ryanshappa/Dynamometer-Project/imgs/wiring.png

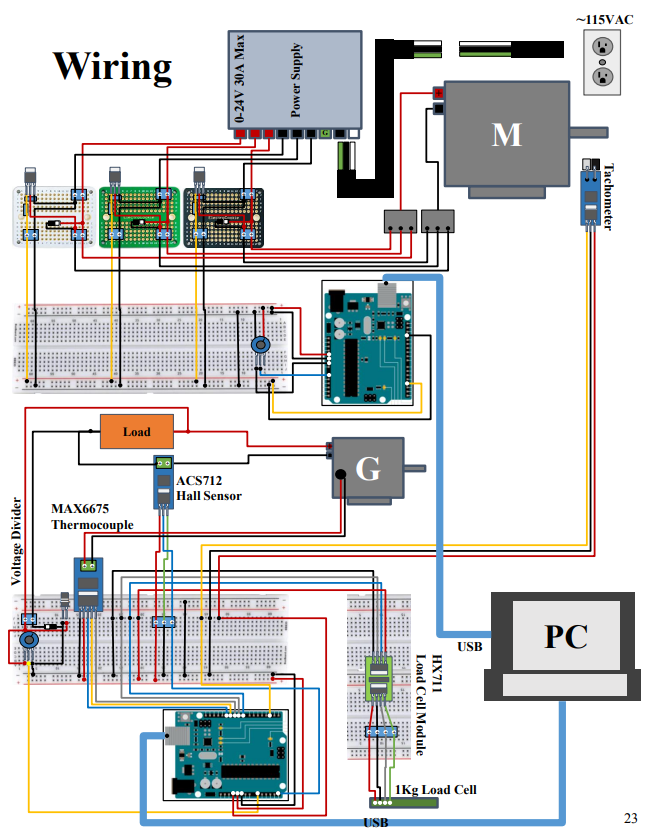
imgs/wiring.png
