ryanshappa/Dynamometer-Project/imgs/dyno_edited.jpg

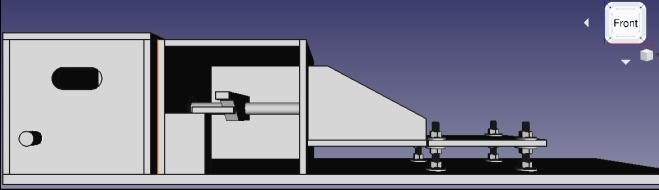
imgs/dyno_edited.jpg
