ryanshappa/Dynamometer-Project/README.md

# Dynamometer-Project
Created a Dynamometer from scratch to take automated metrology tests on any type of generator

All wiring was done from breadboards and code was implemented through multuple Arduinos with code written through Arduino IDE

# IMGS
Check imgs folder for screenshots of conceptual design, wiring diagram, and 3D model created of dynamometer

# Report
Be sure to check out the report that was created explaining the project in more detail and also showing the results of the project!
