ryanshappa/Dynamometer-Project/EGR_450_Final_Report.pdf

Tom DeLine | Capstone

# Engineering 450

# North Central College

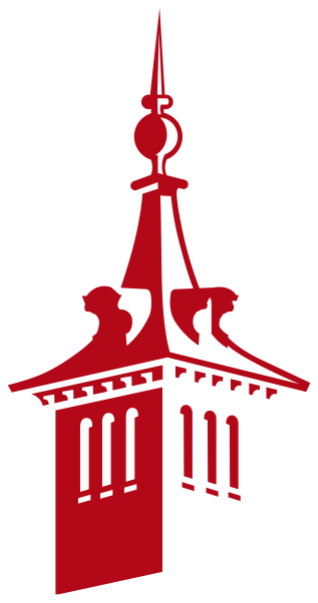
[picture p3: figure]

## Engineering Student: Tom DeLine

## Engineering Professor: Dr Harwath

## Capstone Project

## Subject: Dynamometer

Start: | 8/31/2021
End: | 12/12/2021

## Ryan Shappa & Tom Deline

## Executive Summary

## Problem Statement

## Specifications

## - Subcomponent Specifications

## Concept

## Design

## Wiring

## Design Analysis

## Bill of Material

## Budget

## Schedule

## Results/Data

## Generator Performance

## Conclusion

## References

# Table of Contents

3
4
5
6-13
14
15-22
23
24-30
31
32
33
34-39
40-46
47
48

The purpose of this project was to build a machine capable of measuring the performance of

electric motors and generators. To evaluate performance, the Dynamometer motor is directly

coupled to the shaft of the motor/generator being measured. Once coupled, the machine determines

how much torque is required to spin the shaft at different RPMs with an electric load attached to the

electric terminals of the motor/generator being measured.

To determine the torque required,

the motor of the Dynamometer is mounted in the machine

such that the body of the motor is capable of freely rotating

about the central axis of the shaft. By measuring the rotational

force applied to the central axis shaft while the machine is on, a relationship can be developed

between torque, RPM, and load.

To control the Dynamometer, a serial console session can be established with the machine by USB

cable. After establishing the connection,

the user is prompted with a decision tree

to select how the machine operates.

In Dynamometer mode, the user can

select from a list of speed profiles;

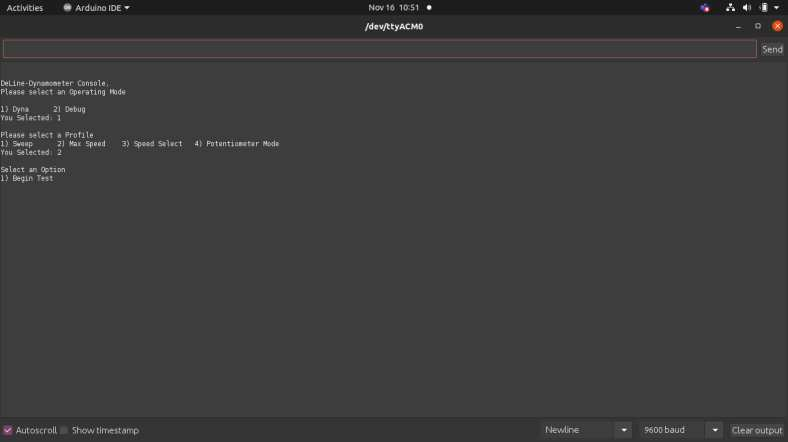
[picture p4: figure]

1)Sweep | 2)Max Speed | 3)Speed Select | 4)Potentiometer Mode

The data is recorded in a csv file through a second serial connection monitored and recorded by

putty console logger. The output can be exported to a graphing program such as Microsoft Excel.

# Executive Summary

Load Cell

Fig 1: Machine motor body
rotating around central shaft

Fig 2: Serial Console Session Established through Arduino IDE

# Problem Statement

The customer requires the ability to evaluate

the power output of a motor/generator to determine

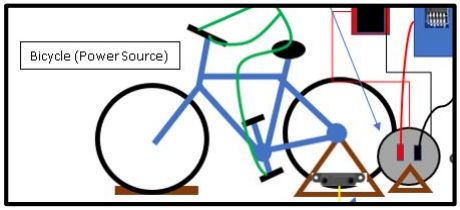
[picture p5: figure]

the feasibility of using different motor sizes/types

for a bicycle powered electric generator.

The generator attached to the bicycle in Fig 3 is the

component which the customer requires the ability

to be evaluated.

A dynamometer is a device capable of evaluating motor performance under load. The

dynamometer needs to be capable of measuring RPM, determine the output Voltage/Current from

the generator, determine the torque required to spin the motor, and measure the motor temperature vs

power output. Normally, this type of machine (dynamometer) would measure the torque produced

by the motor being evaluated. In this specific application however, the machine measures the torque

required to rotate the generator shaft for loaded/unloaded conditions.

Fig 3: Customer’s bicycle powered
electric generator

# Specifications

Dynamometer: This machine is capable of evaluating the performance of electric motors/generators.

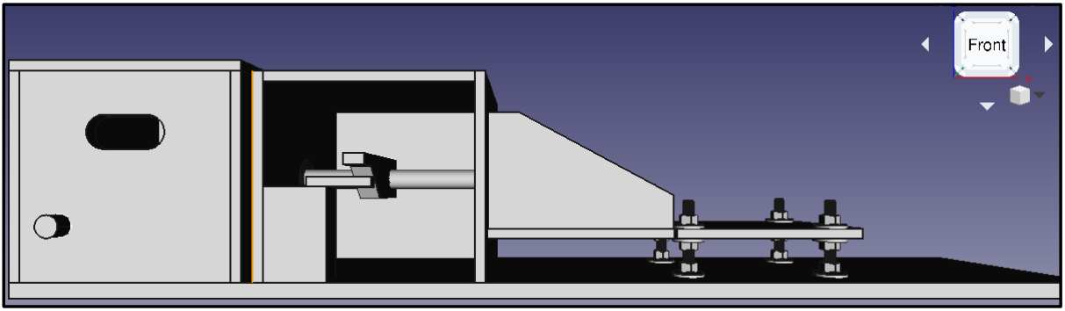
[picture p6: figure]

COST | $276
MACHINE MOTOR OUTPUT | 500W
MAX SPEED | 2500 RPM
INPUT VOLTAGE | 120/240V AC
ELECTRICAL PLUG | NEMA 5-15P
PEAK CURRENT | 20A
NO-LOAD CURRENT | 2.2A
MAX TORQUE | 2 Nm
MAX ATTACHED MOTOR TORQUE | 2 Nm
MAX ATTACHED MOTOR WEIGHT | 20lbs
MACHINE WEIGHT | 50lbs
MAX ATTACHED MOTOR POWER | 480W
MACHINE FLOOR SPACE | 240mm Wide x 720mm Long x 250mm Tall
MACHINE INTERFACE | USB-B x 2
SPEED PROFILES | 4

Fig 4: Dynamometer Machine Assembly

# Specifications Continued

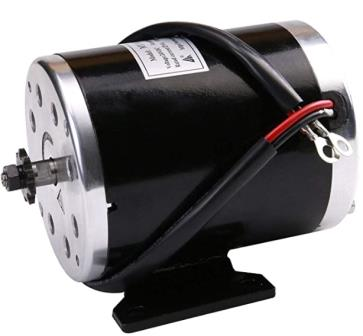
[picture p7: figure]
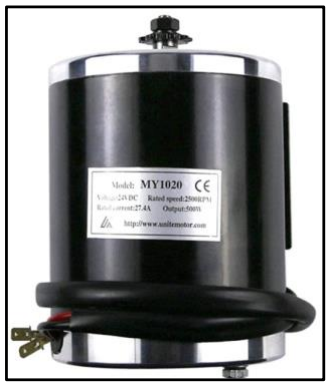
[picture p8: figure]
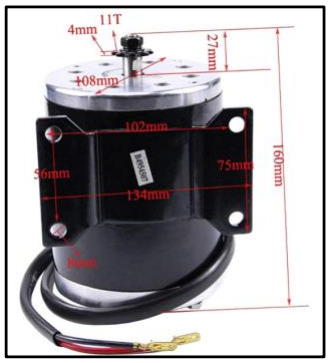
[picture p9: figure]
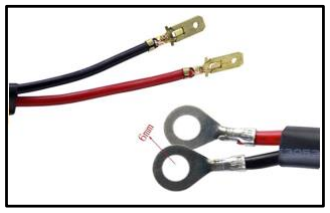
[picture p10: figure]

https://www.amazon.com/WPHMOTO-Brushed-Electric-Scooter-Bicycle/dp/B078RKRV5P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

## Product Link:

COST | $78.89
OUTPUT | 500W
RATED SPEED | 2500 RPM
RATED VOLTAGE | 24V DC
RATED CURRENT | 27.4A
NO-LOAD CURRENT | 2.2A
RATED TORQUE | 1.5Nm
PEAK EFFICIENCY AT 24V | 78%
REVERSIBLE | (with polarity swap)
MOTOR WEIGHT | 9lbs (4kg)
MAXIMUM LOAD | 200lbs (90kg)

## Dynamometer Motor:

## Dynamometer Power Supply:

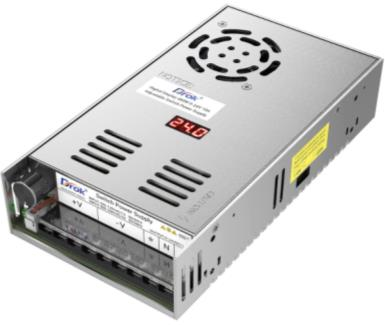
[picture p11: figure]
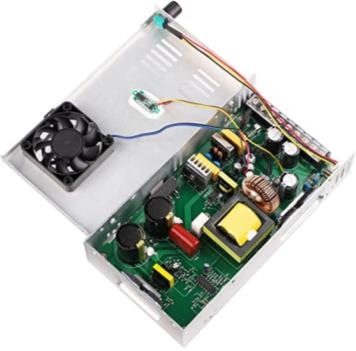
[picture p12: figure]
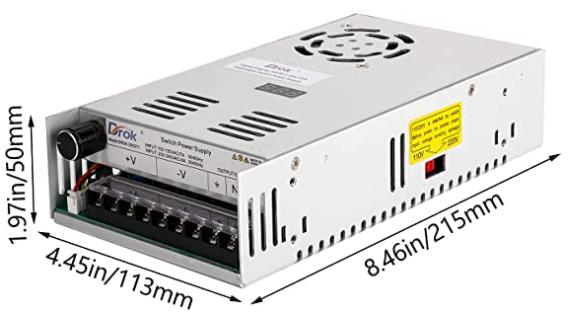
[picture p13: figure]
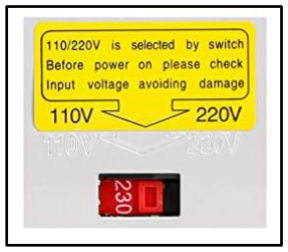
[picture p14: figure]

Amazon.com: Adjustable Voltage DC Power Supply, DROK AC 110V-220V to DC Output 0-24V, LED Digital Display 12V 24V 20A 480W Switching Power Supply Regulated Converter Step Down Transformer Built in Cooling Fan : Electronics

## Product Link:

COST | $35.99
OUTPUT POWER | 480W
INPUT VOLTAGE | 110V-220V
RATED OUTPUT VOLTAGE | 0-24V DC
MAX OUTPUT CURRENT | 20A
WEIGHT | 1.94lbs (0.88kg)

# Specifications Continued

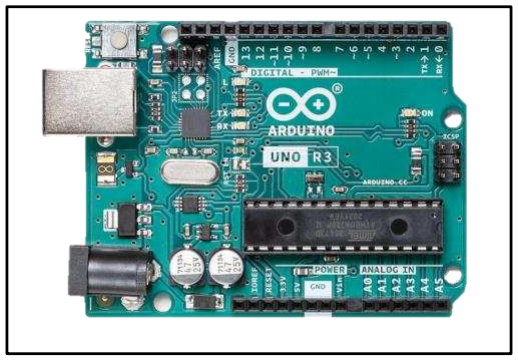
[picture p15: figure]

COST | $23.00
MICROCONTROLLER | ATmega328P
OPERATING VOLTAGE | 5V
INPUT VOLTAGE (RECOMMENDED) | 7-12V
INPUT VOLTAGE (LIMIT) | 6-20V
DIGITAL I/O PINS | 14 (of which 6 provide PWM output)
PWM DIGITAL I/O PINS | 6
ANALOG INPUT PINS | 6
DC CURRENT PER I/O PIN | 20 mA
DC CURRENT FOR 3.3V PIN | 50 mA
FLASH MEMORY | 32 KB (ATmega328P) of which 0.5 KB used by bootloader
SRAM | 2 KB (ATmega328P)
EEPROM | 1 KB (ATmega328P)
CLOCK SPEED | 16 MHz
LED_BUILTIN | 13
LENGTH | 68.6 mm
WIDTH | 53.4 mm
WEIGHT | 25 g

## Product Link:

https://store-usa.arduino.cc/products/arduino-uno-rev3

## Dynamometer Controller:

# Specifications Continued

## Dynamometer Controller Continued:

# Specifications Continued

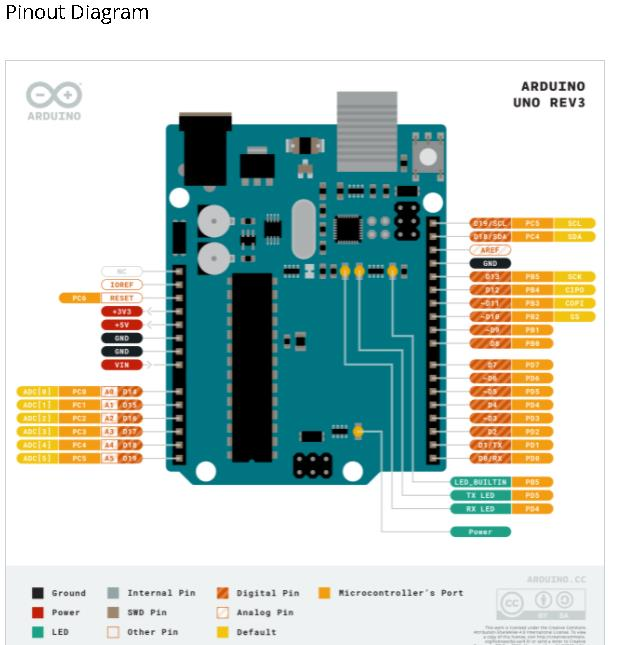
[picture p16: figure]

Fig 4: Dynamometer Controller Pin Diagram

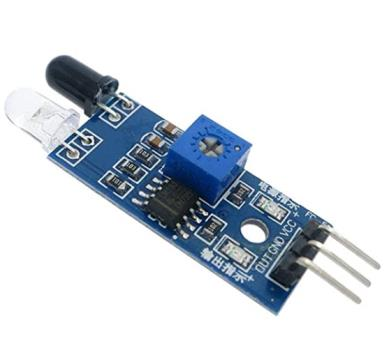
[picture p17: figure]

## Product Link:

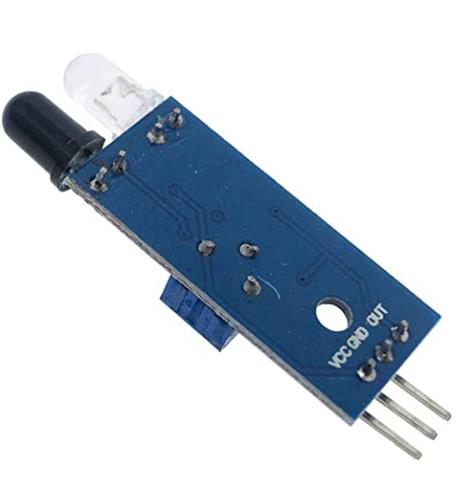
[picture p18: figure]

Amazon.com: HiLetgo 10pcs IR Infrared Obstacle Avoidance Sensor Module for Arduino Smart Car Robot 3-Wire Reflective Photoelectric for Arduino Smart Car Robot : Electronics

COST | $0.83 / Module
BRAND NAME | HiLetgo
COLOR | Blue
VOLTAGE | 3.3V / 5V
MINIMUM DISTANCE | 2cm
MAXIMUM DISTANCE | 30cm
DIGITAL I/O PINS | 3
PIN DEFINITION | OUT, GND, VCC
INTERFACE | I2C
SIZE | 15mm x 34.5mm
VALUE ADJUST | Potentiometer

# Specifications Continued

## Photoelectric Tachometer:

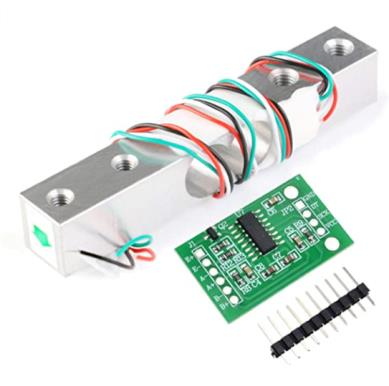
[picture p19: figure]
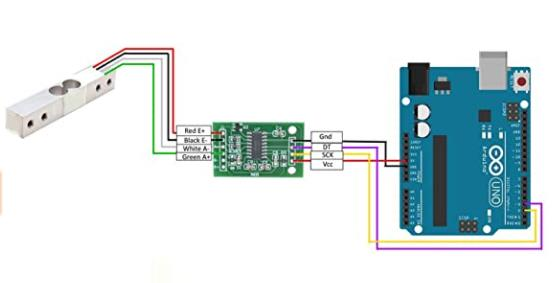
[picture p20: figure]

## Product Link:

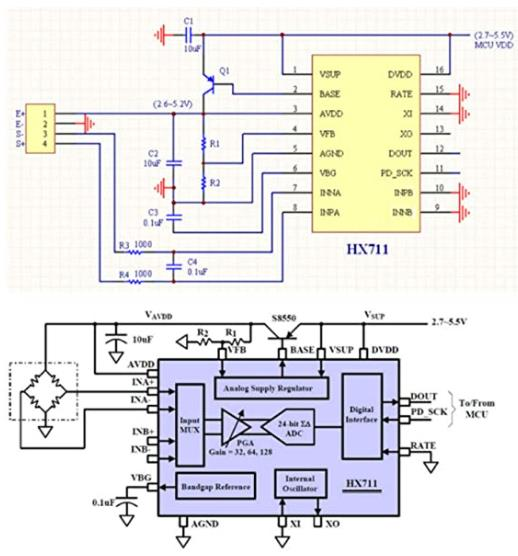
[picture p21: figure]
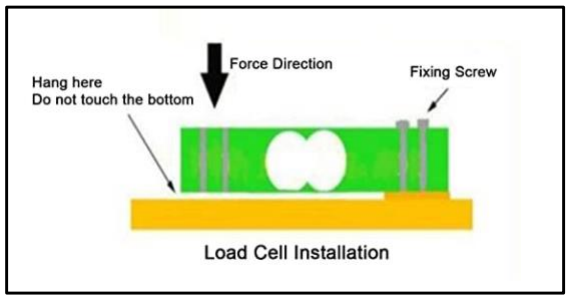
[picture p22: figure]

Amazon.com: ALAMSCN Digital Load Cell Weight Sensor + HX711 Weighing Sensor ADC Module for Arduino DIY Portable Electronic Kitchen Scale Kit (1KG+HX711) : Industrial & Scientific

COST | $7.99
BRAND NAME | ALAMSCN
OUTPUT DATA RATE | 10Hz or 80Hz
VOLTAGE | 5V-10V
MAX LOAD FORCE | 1Kg
ACCURACY | 0.1g
DIGITAL I/O PINS | 4
PIN DEFINITION | GND, DT, SCK, VCC
INTERFACE | I2C

# Specifications Continued

## Digital Load Cell with Module

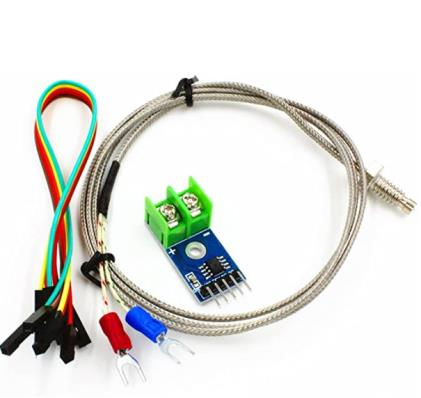
[picture p23: figure]

## Product Link:

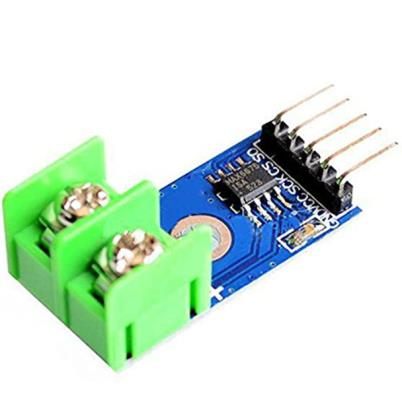
[picture p24: figure]

Amazon.com: ALAMSCN Digital Load Cell Weight Sensor + HX711 Weighing Sensor ADC Module for Arduino DIY Portable Electronic Kitchen Scale Kit (1KG+HX711) : Industrial & Scientific

COST | $7.99
BRAND NAME | ALAMSCN
OUTPUT DATA RATE | 10Hz or 80Hz
VOLTAGE | 3.3V / 5 V
MIN TEMP | 0°C
MAX TEMP | 1024°C
DIGITAL I/O PINS | 5
PIN DEFINITION | GND, VCC, SCK, CS, SO
INTERFACE | SPI
MODULE SIZE | 15mm x 28mm

# Specifications Continued

## Thermocouple with Module

## Product Link:

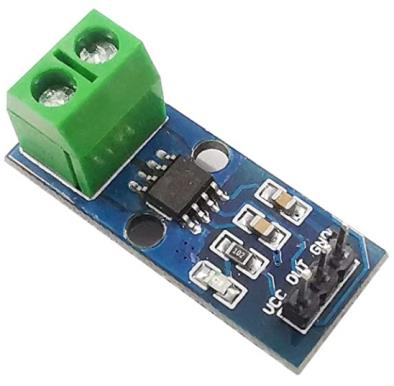
[picture p25: figure]

Amazon.com: ZkeeShop 5pcs 5A Current Sensor Module ACS712 Module Compatible for Arduino : Electronics

COST | $12.99
BRAND NAME | ZkeeShop
VOLTAGE | 5 V
MIN CURRENT | 0
MAX CURRENT | 30A
DIGITAL I/O PINS | 3
PIN DEFINITION | VCC, Out, GND
INTERFACE | Analog Voltage
MODULE SIZE | 15mm x 28mm

# Specifications Continued

## Current Sensor Module

# Concept

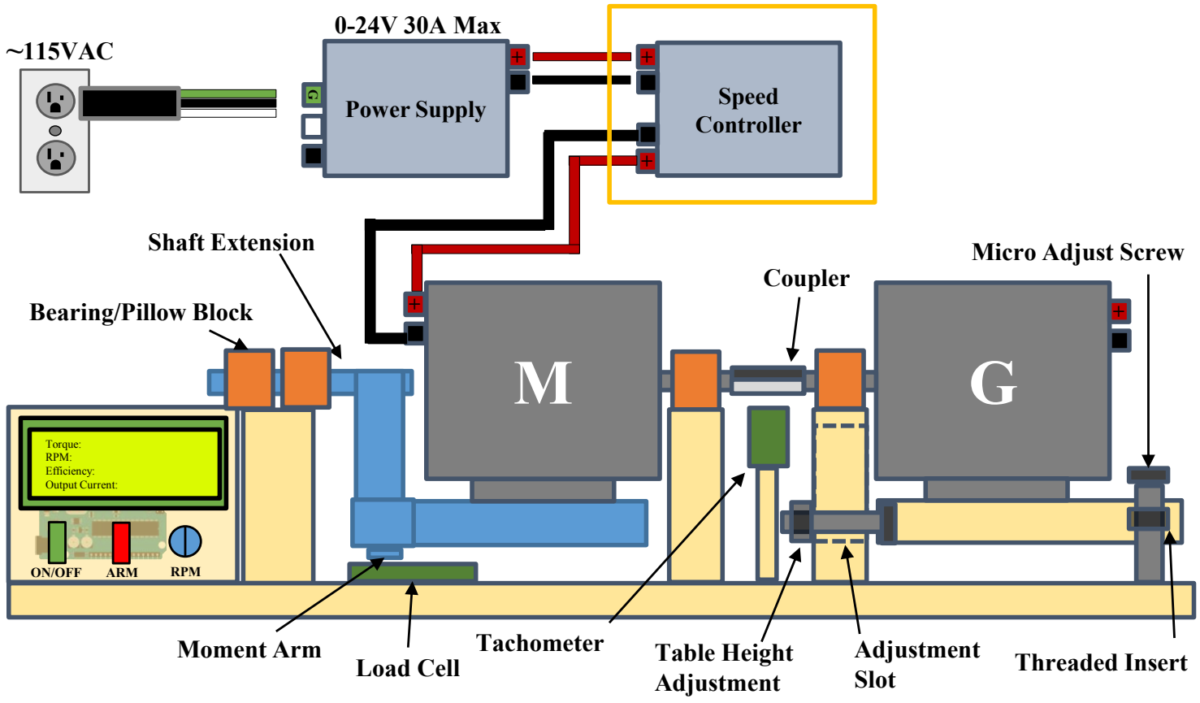
[picture p26: figure]
Bearing/Pillow Block; Shaft Extension; Coupler; Threaded Insert; Micro Adjust Screw; Table Height Adjustment; Adjustment Slot; Torque: RPM: Efficiency: Output Current:; Tachometer; Load Cell; ON/OFF; RPM; Moment Arm; ARM; ~115VAC; Power Supply; 0-24V 30A Max; Speed Controller
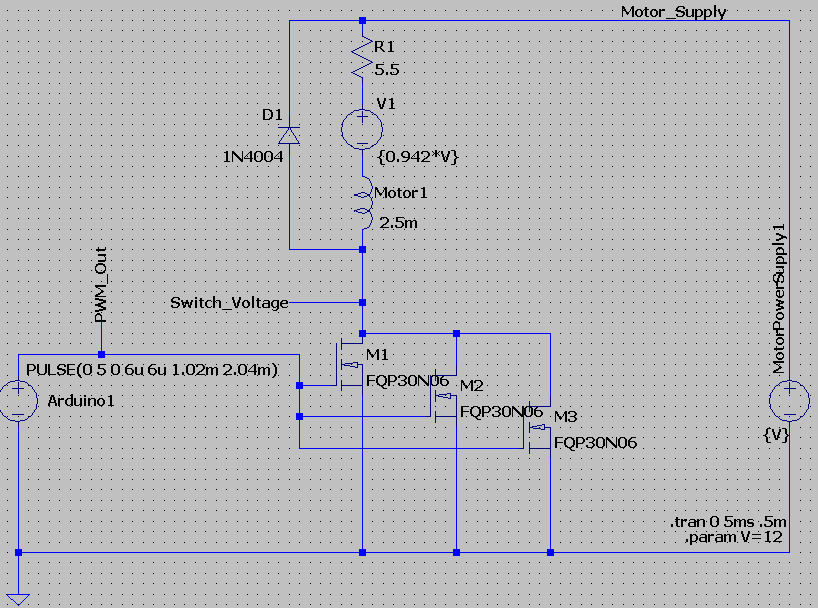
[picture p27: figure]

Fig 6: Motor Speed Controller Circuit

Fig 5: Dynamometer Concept Diagram

# Design

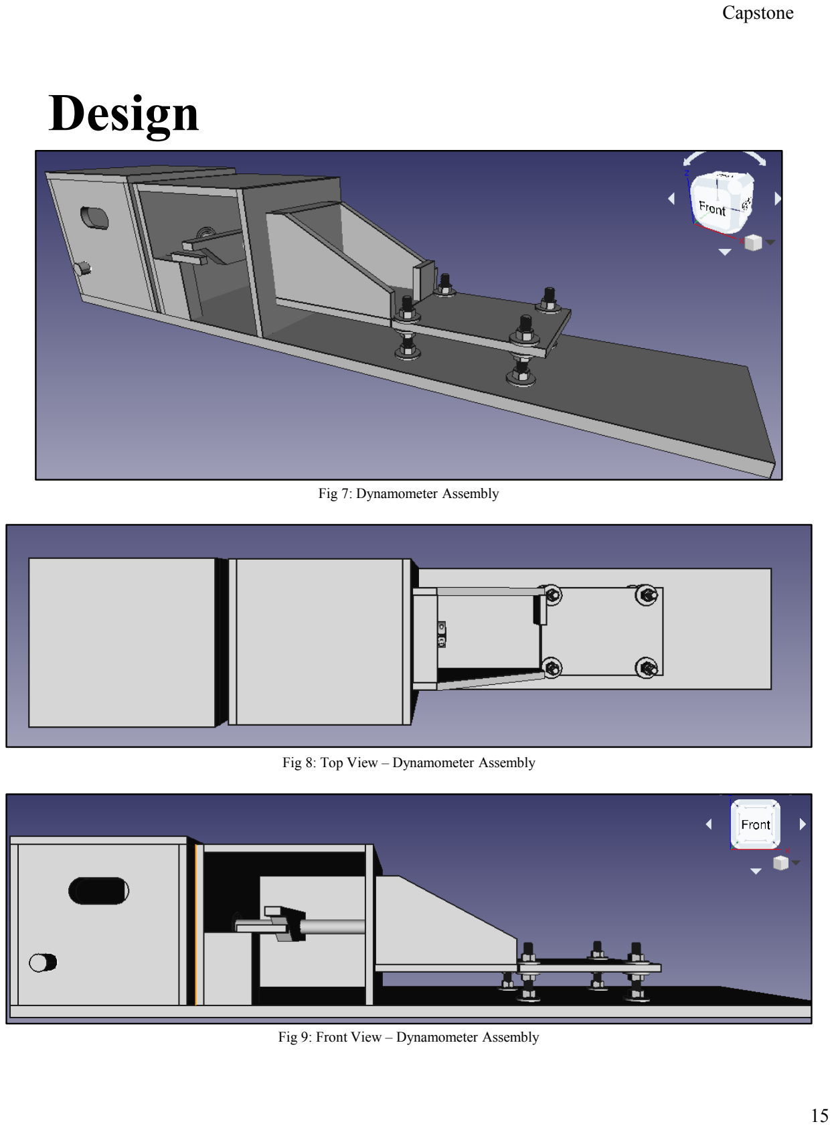
[picture p28: page 15]

Fig 7: Dynamometer Assembly

Fig 8: Top View – Dynamometer Assembly

Fig 9: Front View – Dynamometer Assembly

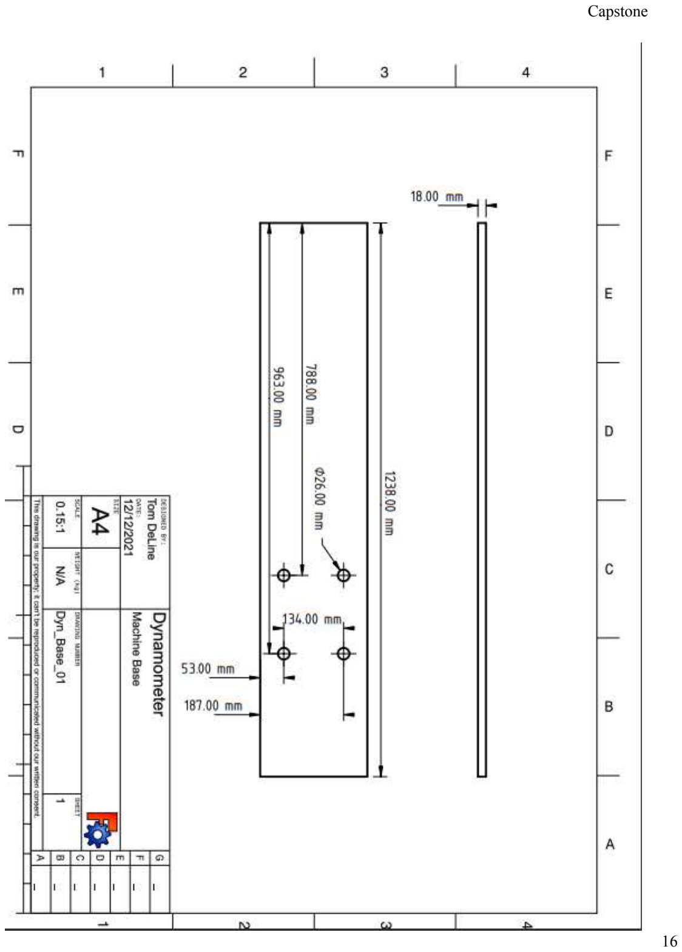
[picture p29: page 16]
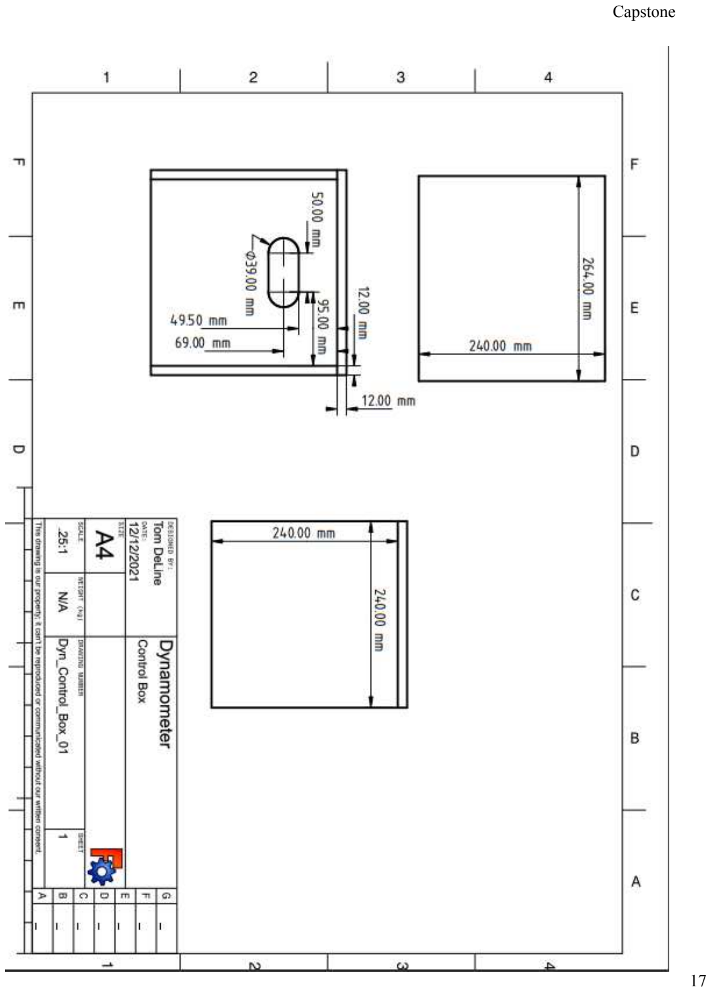
[picture p30: page 17]
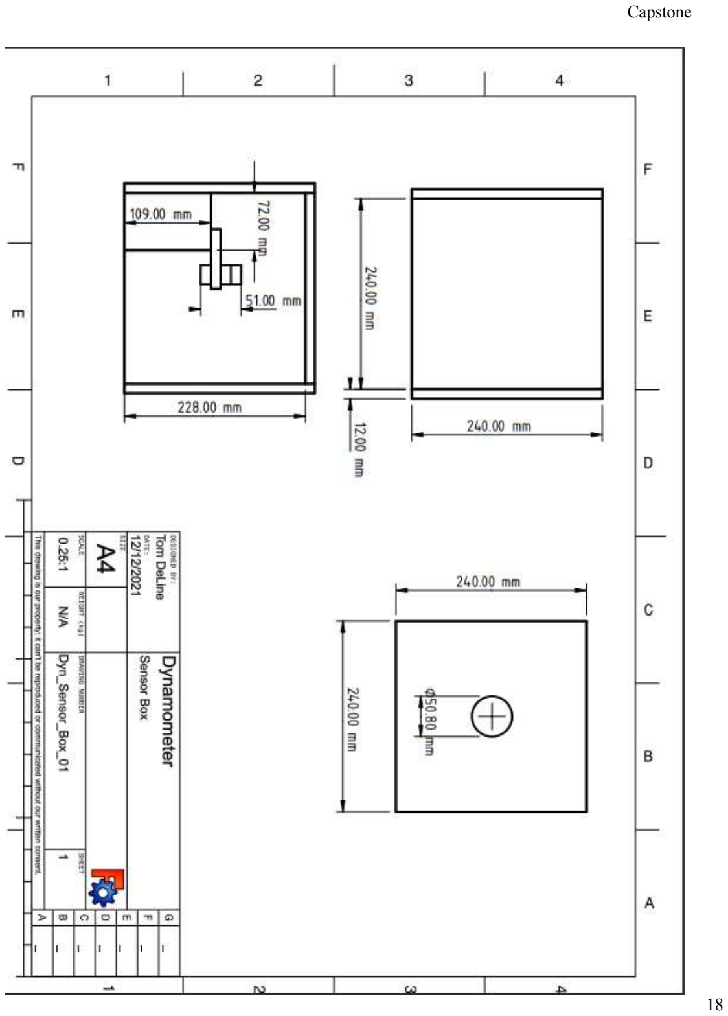
[picture p31: page 18]
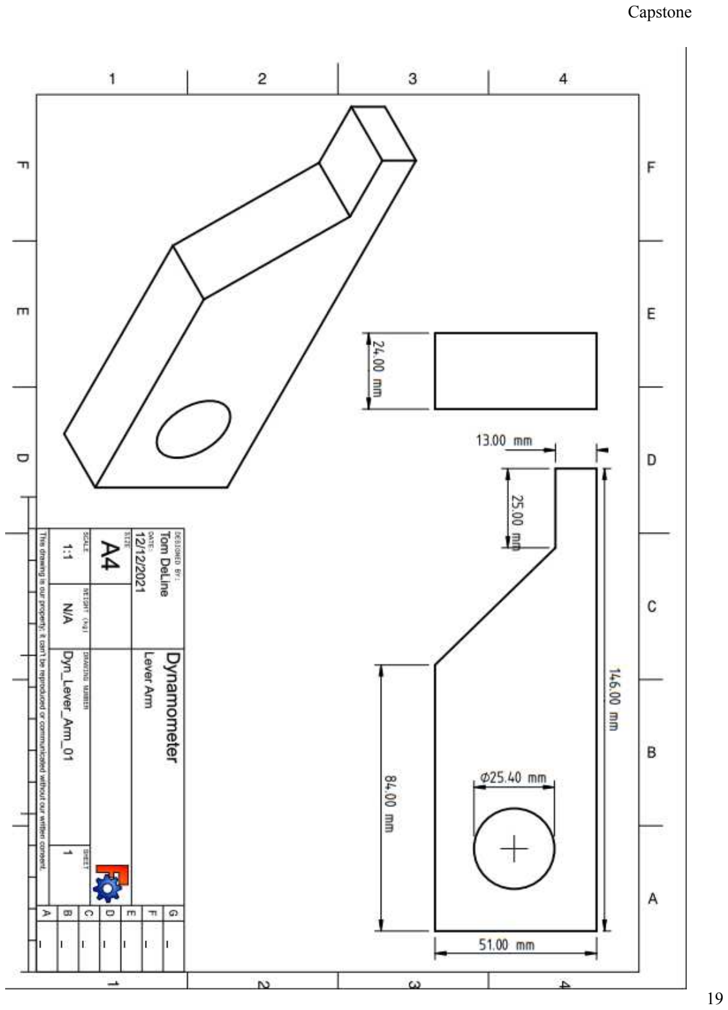
[picture p32: page 19]
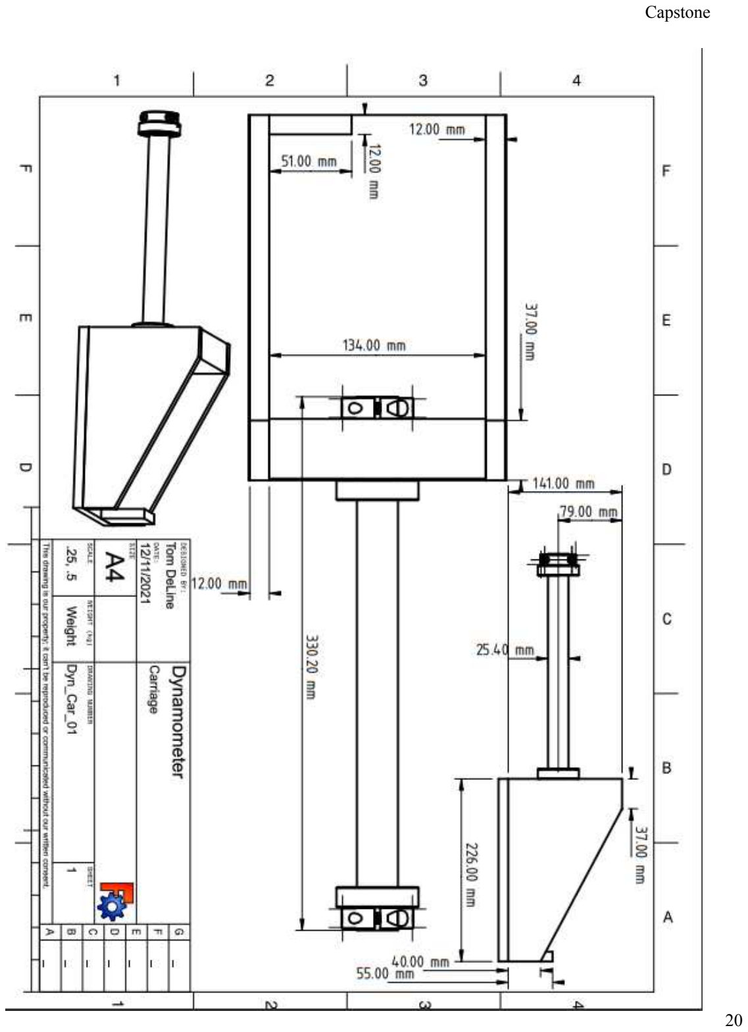
[picture p33: page 20]
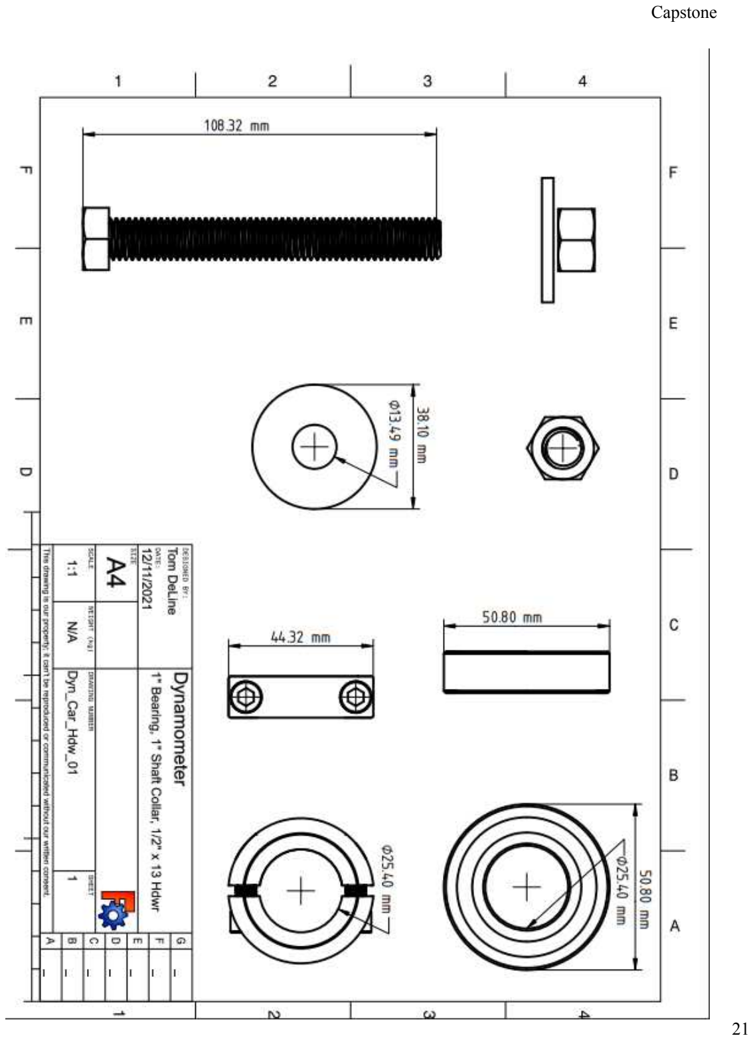
[picture p34: page 21]
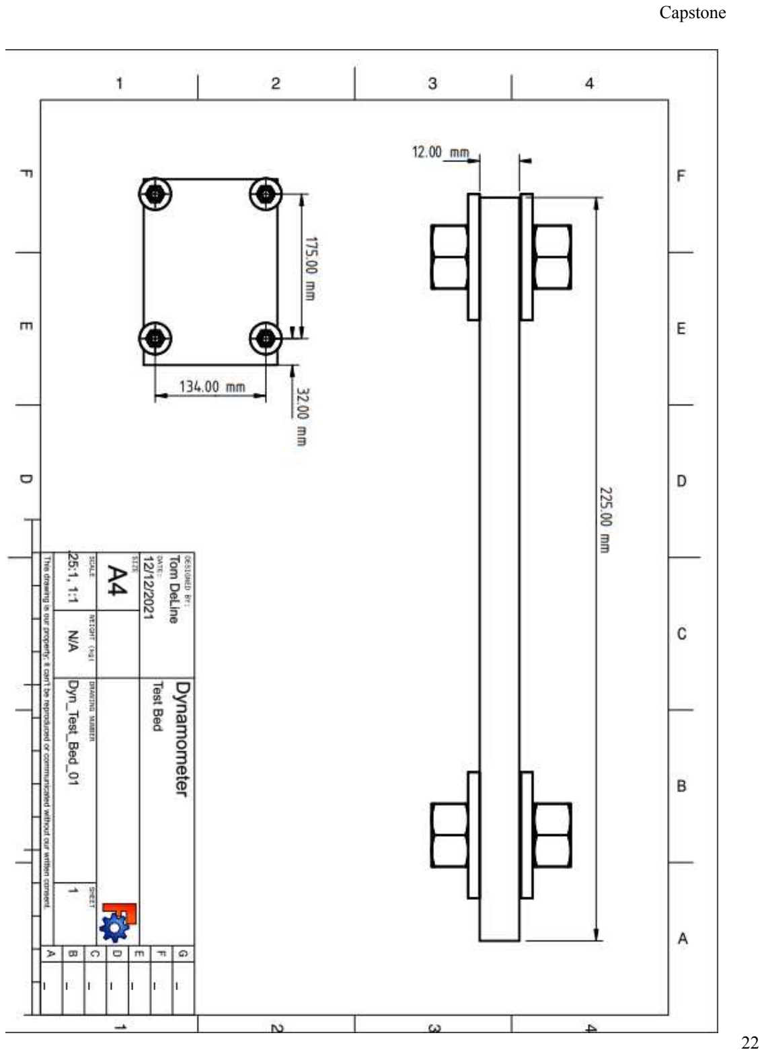
[picture p35: page 22]

M

# Wiring

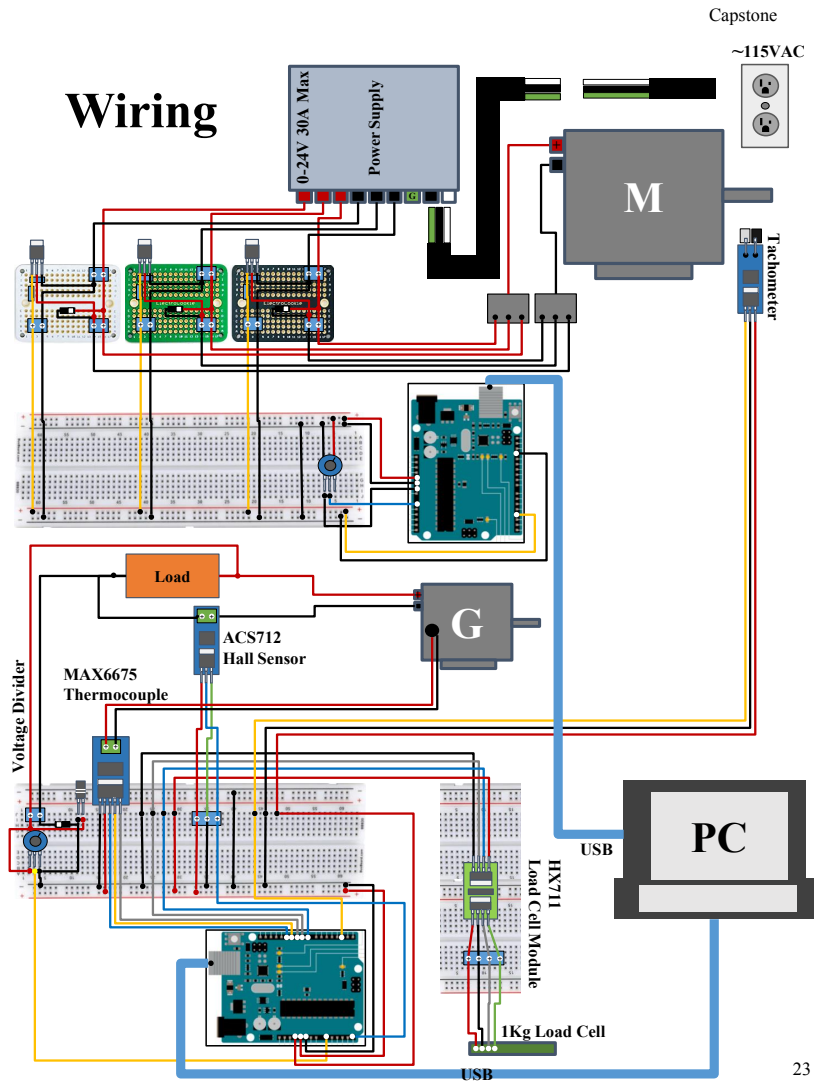
[picture p36: page 23]
~115VAC; G G Power Supply; 0-24V 30A Max; Load; 1Kg Load Cell; USB; Tachometer; ACS712 Hall Sensor; MAX6675 Thermocouple; Voltage Divider

Load Cell Module

# Design Analysis

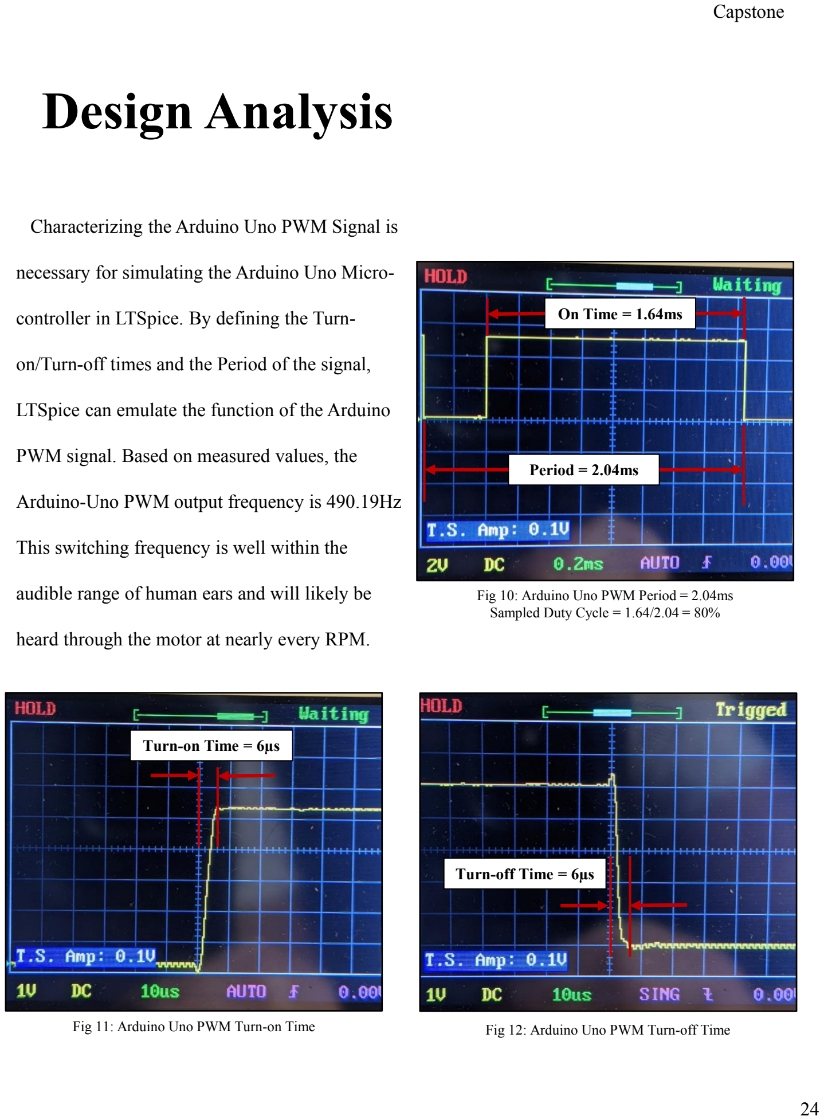
[picture p37: page 24]

Fig 10: Arduino Uno PWM Period = 2.04ms Sampled Duty Cycle = 1.64/2.04 = 80%

Period = 2.04ms

On Time = 1.64ms

Turn-on Time = 6µs

Fig 11: Arduino Uno PWM Turn-on Time

Turn-off Time = 6µs

Fig 12: Arduino Uno PWM Turn-off Time

Characterizing the Arduino Uno PWM Signal is

necessary for simulating the Arduino Uno Micro-

controller in LTSpice. By defining the Turn-

on/Turn-off times and the Period of the signal,

LTSpice can emulate the function of the Arduino

PWM signal. Based on measured values, the

Arduino-Uno PWM output frequency is 490.19Hz

This switching frequency is well within the

audible range of human ears and will likely be

heard through the motor at nearly every RPM.

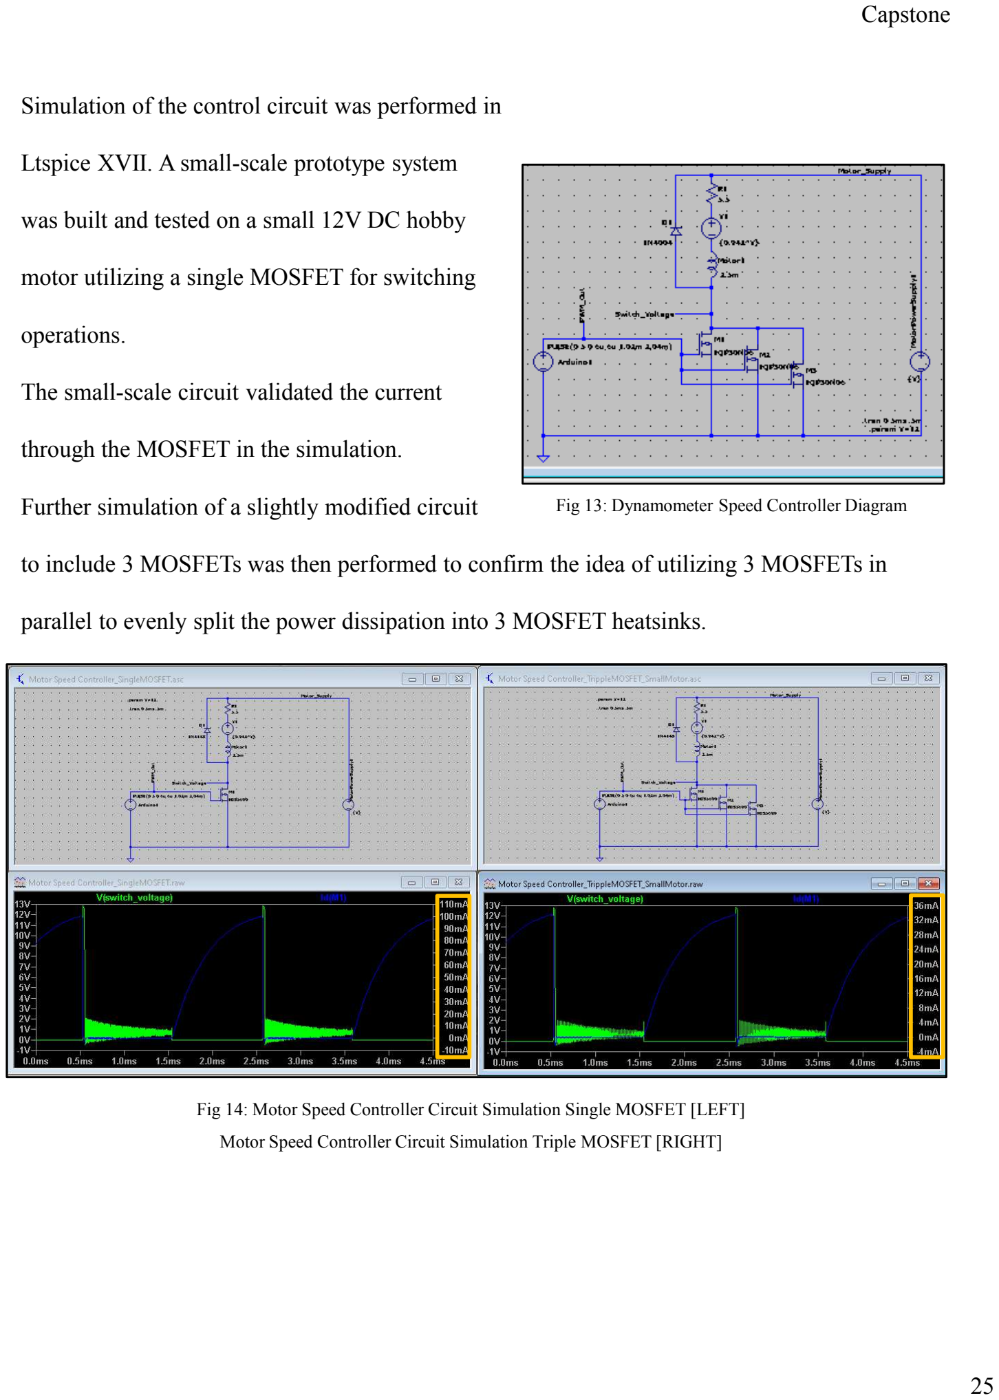
[picture p38: page 25]

Simulation of the control circuit was performed in

Ltspice XVII. A small-scale prototype system

was built and tested on a small 12V DC hobby

motor utilizing a single MOSFET for switching

operations.

The small-scale circuit validated the current

through the MOSFET in the simulation.

Further simulation of a slightly modified circuit

to include 3 MOSFETs was then performed to confirm the idea of utilizing 3 MOSFETs in

parallel to evenly split the power dissipation into 3 MOSFET heatsinks.

Fig 14: Motor Speed Controller Circuit Simulation Single MOSFET [LEFT]

Motor Speed Controller Circuit Simulation Triple MOSFET [RIGHT]

Fig 13: Dynamometer Speed Controller Diagram

Power dissipated by the MOSFET is the power lost from RDS while switching states.

Simulations showed 123.22mW for average power dissipation through a single MOSFET

version of the motor speed controller. The FQP30N06 has the following Thermal Resistance

Properties;

1) Junction to Case = 1.90℃
W
2) Junction to Ambient = 62.50℃
W

Therefore,
62.50 ℃
W

x 0.12322 W
1

# = 7.70125℃ and 1.90 ℃

W

x 0.12322 W
1

= 0.24℃

Total temperature rise of the MOSFET is then calculated

7.70125℃ + 0.24℃ = 7.94125℃ + 25℃ = 32.94125℃

which further yields the case temperature in ambient conditions under no load.

To understand the maximum power dissipation of the MOSFET under the maximum motor

## voltage ‘V’ and current ‘I’ condition

# RDS ON x IMAX = VMOSFET

# 0.4 Ω x 27.4 A = 1.096 V x 27.4 A = 30.0304 W Power Dissipation

since V x I = P.

A simple calculation of the case temperature rise with heatsink can be concluded from;

# TJ = P RJC + RCH + RHA + TA

1) Tj = Temperature of the semiconductor junction, TA is ambient temp
2) RJC = Thermal resistance between junction and case = 1.90 ℃
W
3) RCH = Thermal resistance between case and heatsink = 0.25 ℃
W
with thermal paste
4) RHA = Thermal resistance between heat sink and ambient = 2.70 ℃
W
for chosen heat sink

In order to provide a safety factor for the MOSFETs, the calculated power dissipation

requirement will be doubled to 60W.

Therefore;

# TJ = 60W 1.90

℃
W

+ 0.25

℃
W

+ 2.7

℃
W

+ 25℃ = 316℃

which is well above the 175°C maximum case temperature for the FQP30N06.

Splitting the thermal load between three MOSFETs should reduce the maximum calculated

temperature of the case by approximately one third keeping TMax near 100°C per case.

In order to determine the size of the required load cell for the Dynamometer, it is necessary

to calculate the Torque produced by the motor under max load conditions. Since the machine motor is 500W and rated at 2500RPM, the Torque (τ) of the motor can be found after

converting Revolutions Per Minute (RPM) to Radians Per Second.
2500

# revolutions minute

x 2π

# radians revolution x

1
60

# minute seconds = 261.79

# radians second

Since Power = Torque x Speed,

# τMax =

# PMax

# ωMax

=

500W

# 261.79 radians second

# =1.9Newton ∙ meters Nm = 0.194kgm

Therefore, at 1m from the center axis of rotation, the motor would apply 0.194kg force

through a lever arm of 1m. To prevent the machine from being 1m wide, the lever arm can be

shortened by;

# Torque τ = Force N x radius m → 1.9Nm = F x 0.25m → F = 7.7N = 0.78kg

With F = 0.78kg the load cell then should be capable of reading values from 0-1kg.

To determine the load for the generator output, the maximum power output can be calculated

### 24 V x 14 A = 336 W , but because of internal loses and friction, the manufacturer of the

generator motor

claim 250(W) power output. Since the generator motor will output steady voltage at a given ω,

increasing the load will increase the current

consumption at given voltage. The first proposed

generator load was lights/heat lamps. If a heat lamp were used as a load and assuming a linear relationship 120(V)

# 2.1 A

=
24(V)

x(A) → x = 0.420 A at 24(V), which uses 10.08(W). In order

to draw 250(W) out of the generator, the machine would need roughly 25 x 250(W) heat

lamps operating at 24(V). A more feasible load solution then is a power resistor. Power

resistors are high current load resistors that dissipate heat through an aluminum heatsink

case. In order to draw the maximum power from the generator, the load should be impedance matched. The generator motor characteristics are 24V = 14 A x R → R = 1.71Ω. To

## meet the customer’s load requirements, 2 x 100W (2 Ω) power resistors can be wired in

series with the generator output.

0

0.5

1

1.5

2

2.5

0 | 20 | 40 | 60 | 80 | 100 | 120

Current (A)

Voltage (V)

Power Used by 250(W) Heat Lamp at 24(V)

Fig 15: Linear VI graph of Heat Lamp

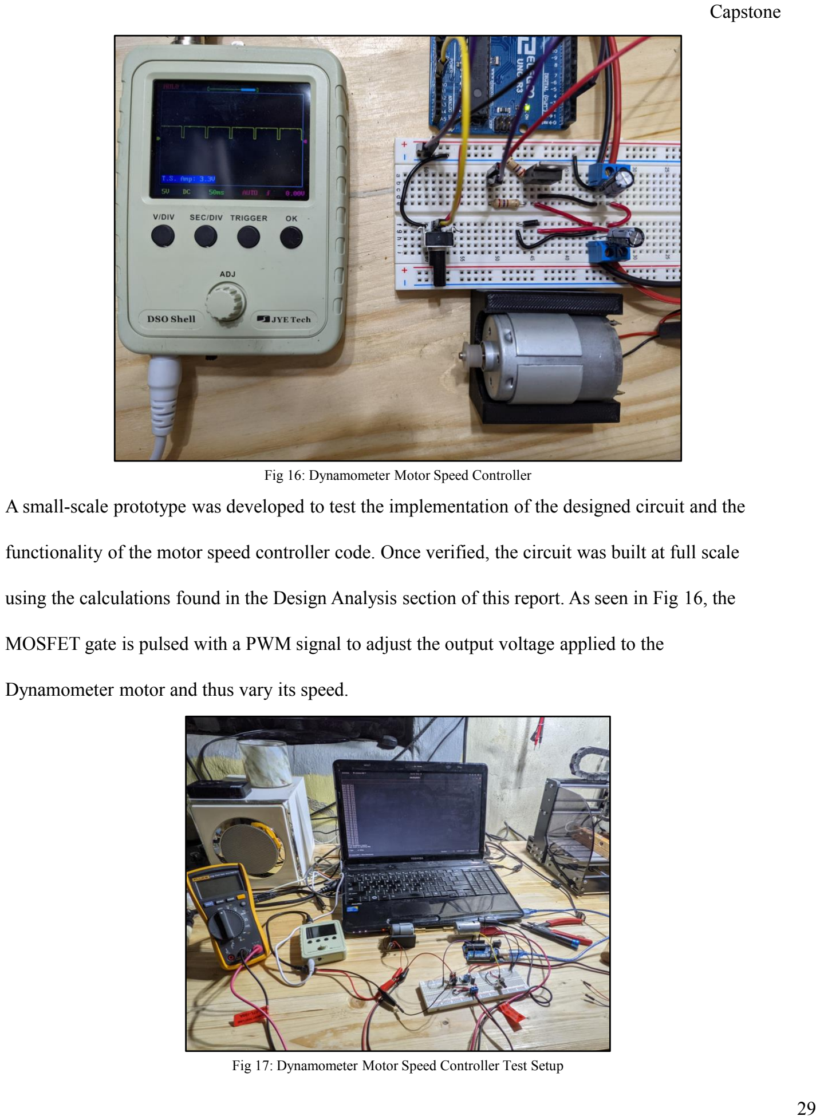
[picture p39: page 29]

A small-scale prototype was developed to test the implementation of the designed circuit and the

functionality of the motor speed controller code. Once verified, the circuit was built at full scale

using the calculations found in the Design Analysis section of this report. As seen in Fig 16, the

MOSFET gate is pulsed with a PWM signal to adjust the output voltage applied to the

Dynamometer motor and thus vary its speed.

Fig 16: Dynamometer Motor Speed Controller

Fig 17: Dynamometer Motor Speed Controller Test Setup

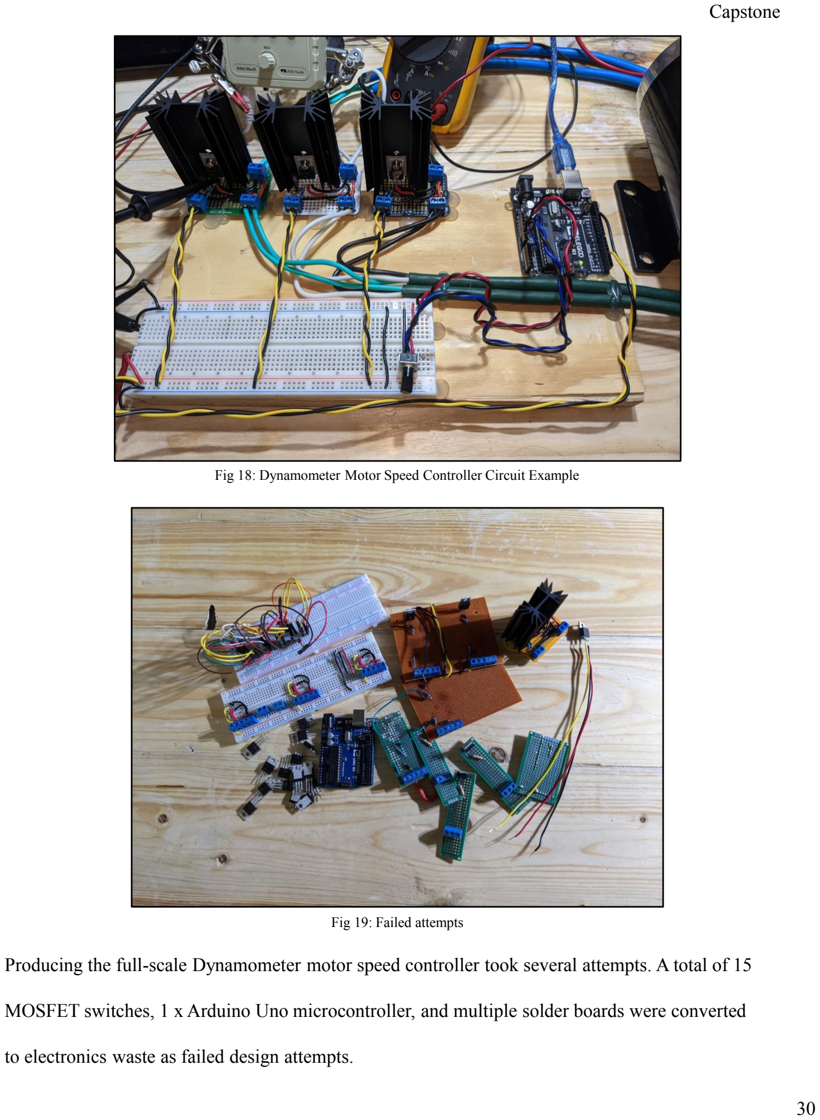
[picture p40: page 30]

Producing the full-scale Dynamometer motor speed controller took several attempts. A total of 15

MOSFET switches, 1 x Arduino Uno microcontroller, and multiple solder boards were converted

to electronics waste as failed design attempts.

Fig 19: Failed attempts

Fig 18: Dynamometer Motor Speed Controller Circuit Example

# Bill of Materials

Bill of Materials

Item # | Item Description | Vendor | Cost | Quantity | Total
1 | 500W DC Motor | Amazon | $78.89 | 1 | $78.89
2 | 480W DC Power Supply | Amazon | $35.99 | 1 | $35.99
4 | Infrared Sensor Module Reflective Photoelectric Light (10-Pack) | Amazon | $8.29 | 1 | $8.29
5 | Load cell 1kg | Amazon | $7.99 | 1 | $7.99
6 | Load cell 5kg | Amazon | $7.99 | 1 | $7.99
7 | 588-FA-T220-64E TO-220 Heat Sink 3°C/W | Mouser | $2.82 | 5 | $14.10
8 | Thermocouple Module | Amazon | $6.99 | 1 | $6.99
| | | | Total | $160.24

Bill of Materials

Item # | Item Description | Vendor | Cost | Quantity | Total
9 | Uxcell 12mm – 12mm Shaft Coupler | Amazon | $13.49 | 1 | $13.49
10 | 30PCS Alligator Clips | Amazon | $9.89 | 1 | $9.89
11 | Comidox 100W 2R Ohm Power Resistors (Set of 5) | Amazon | $8.99 | 1 | $8.99

# Budget

Budget

Item # | Item Description | Vendor | Cost | Quantity | Total
1 | 500W DC Motor | Amazon | $78.89 | 1 | $78.89
2 | 480W DC Power Supply | Amazon | $35.99 | 1 | $35.99
4 | Infrared Sensor Module Reflective Photoelectric Light (10-Pack) | Amazon | $8.29 | 1 | $8.29
5 | Load cell 1kg | Amazon | $7.99 | 1 | $7.99
6 | Load cell 5kg | Amazon | $7.99 | 1 | $7.99
7 | 588-FA-T220-64E TO-220 Heat Sink 3°C/W | Mouser | $2.82 | 5 | $14.10
8 | Thermocouple Module | Amazon | $6.99 | 1 | $6.99
9 | LCD Display | Amazon | $8.59 | 1 | $8.59
10 | Arduino-Uno | Arduino | $23.00 | 1 | $23.00
11 | MOSFETs (10 - Pack) | Amazon | $8.99 | 1 | $8.99
12 | Diodes | Mouser | $0.20 | 10 | $1.98
13 | 100Ω Resistors | Mouser | $0.14 | 10 | $1.43
14 | 1000Ω Resistors | Mouser | $0.56 | 10 | $5.62
15 | Bearings (10-Pack) | Amazon | $30.50 | 1 | $30.50
16 | Steel Rod | McMaster-Carr | $11.83 | 1 | $11.83
17 | Plywood 1/2" 4x8 CDX | Menards | $24.35 | 1 | $24.35
| | | | Total | $276.53

# Schedule

School | North Central College | Legend:
Project lead | Tom DeLine
Project Start Date: | 8/25/2021 | October | November
Scrolling Increment: | 37 | 1 | 2 | 3 | 4 | 5 | 6 | 7 | 8 | 9 | 10 11 12 13 14 | 15 16 17 18 19 20 21 | 22 23 24 | 25 | 26 27 28 | 29 30 31 | 1 | 2 | 3 | 4 | 5 | 6 | 7 | 8 | 9 | 10 11 | 12 13 14 15 16 17 18 | 19 20 21 22 23 24 25
Milestone description | Category | Progress | Start | Days | F | S | S | M | T | W | T | F | S | S | M | T | W | T | F | S | S | M | T | W | T | F | S | S | M | T | W | T | F | S | S | M | T | W | T | F | S | S | M | T | W | T | F | S | S | M | T | W | T | F | S | S | M | T | W | T
Report | Milestone | 75% | 8/25/2021 | 100
Preliminary Report | Goal | 100% | 8/25/2021 | 7
Specifications | Goal | 100% | 8/25/2021 | 45
Concept | Goal | 100% | 8/22/2021 | 30
Simulations | Goal | 100% | 9/10/2021 | 29
Calculations | Goal | 100% | 8/31/2021 | 56

Small Scale Prototype

Build Breadboard | Goal | 100% | 9/21/2021 | 3
Measure Values | Med Risk | 50% | 9/23/2021 | 39
Record Data | Med Risk | 50% | 9/23/2021 | 39

Full Scale Prototype

Control Box | On Track | 50% | 9/22/2021 | 4
Bearing Walls | Med Risk | 5% | 9/22/2021 | 14
Motor Plates | Med Risk | 0% | 9/22/2021 | 6
Machine Base | On Track | 0% | 9/22/2021 | 3
Name Plate | Low Risk | 10% | 11/11/2021 | 14
Measure Values | Low Risk | 0% | 11/4/2021 | 15
High risk | Unassigned

Dynamometer

On track | Low risk | Med risk

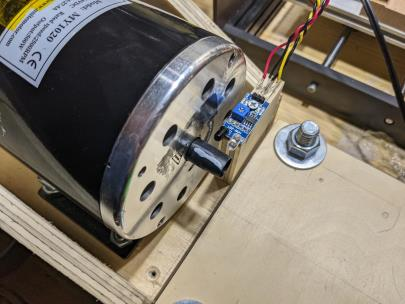
[picture p41: figure]

The first documented measurements with the Dynamometer

were of RPM. To make this measurement, a piece of black

electrical tape was wrapped around the output shaft of the

machine motor. A white chalk marker was then used to

draw a single white line along the shaft as depicted in

Figure 20. An IR distance module was used to track the

amount of time it takes for the white line to make 1 revolution.

The pulseIn(pinToMonitor, Rising/Falling Edge) function built into the Arduino IDE is used

for monitoring the pulse length as received from the IR module each time the white line

reflects the IR light. To calibrate the tachometer, the motor was set to run at 12.0(V). The

oscilloscope in Figure 21 measures the amount of time elapsed between pulses.

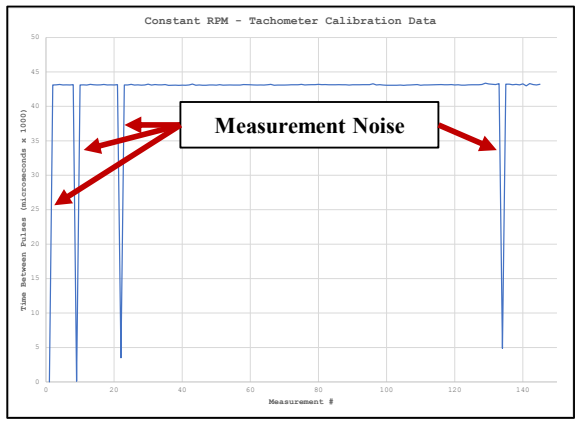
[picture p42: figure]
Measurement #; Measurement Noise
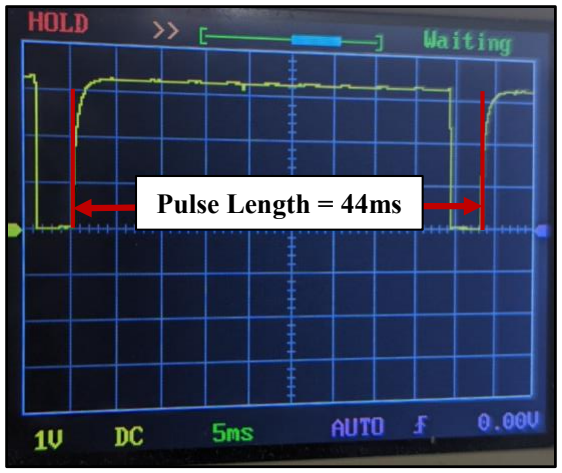
[picture p43: figure]
Pulse Length = 44ms

Since the oscilloscope pulse length matches the length of the pulse measured by the Arduino,

a simple calculation of RPM can be concluded from:

# Results/Data

Time Between Pulses (microseconds x 1000)

Constant RPM - Tachometer Calibration Data

Fig 20: Motor shaft with tape and white line

Fig 21: Tachometer Pulse goes LOW each time the rotor makes 1 rotation

Fig 22: One-hundred forty - sequential measurements of pulse length using Arduino IDE pulseIn( ) function. Motor held at constant 12V

# Revolutions minute

=

1

# microseconds revolution

x 1000

μs
s

x 60

# seconds minute

Where time is initially recorded in microseconds but can be converted to minutes through

basic unit analysis. As seen in Figure 23,

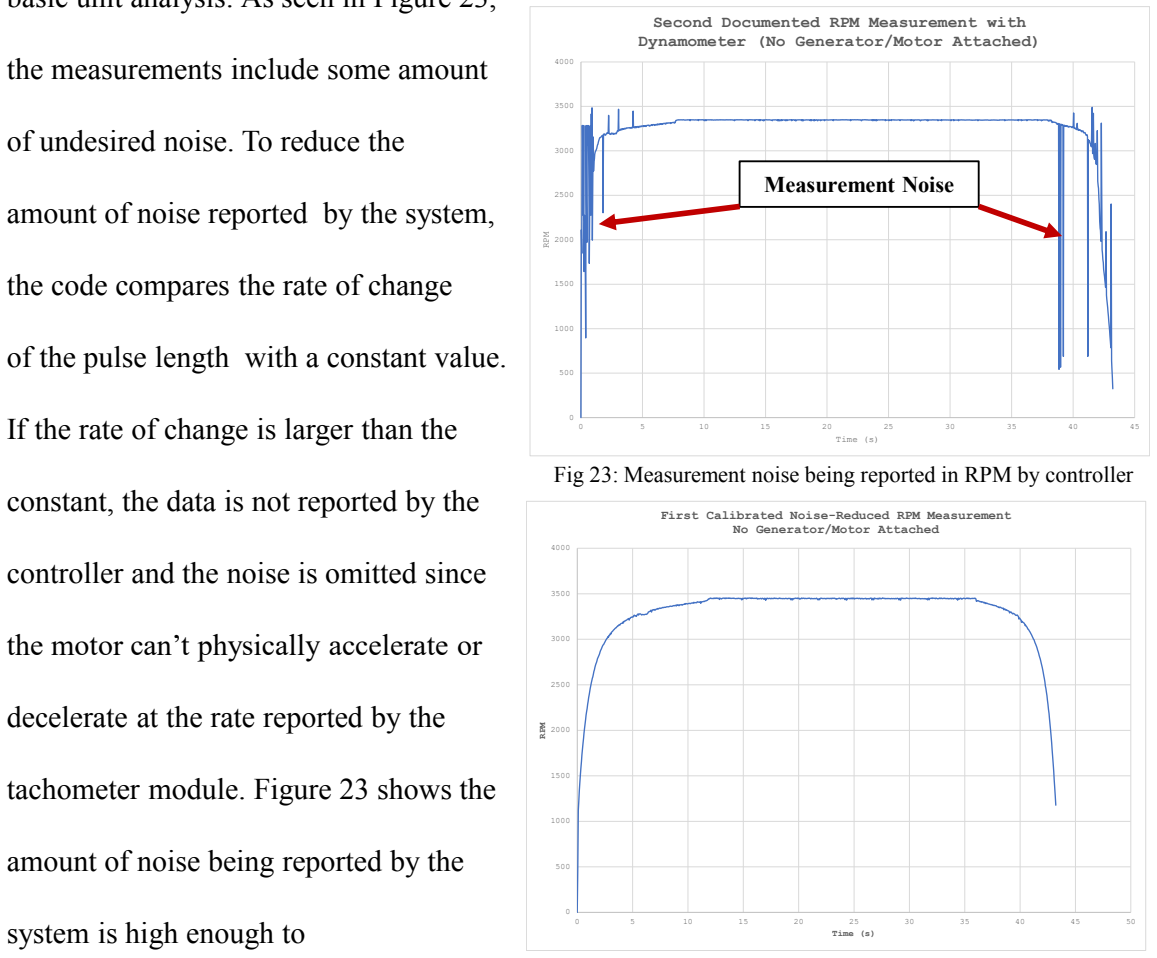
[picture p44: figure]
the measurements include some amount; of undesired noise. To reduce the; amount of noise reported by the system,; the code compares the rate of change; decelerate at the rate reported by the; tachometer module. Figure 23 shows the; amount of noise being reported by the; system is high enough to; RPM; Time (s); Second Documented RPM Measurement with Dynamometer (No Generator/Motor Attached); Measurement Noise; First Calibrated Noise-Reduced RPM Measurement No Generator/Motor Attached

of the pulse length with a constant value.

If the rate of change is larger than the

constant, the data is not reported by the

controller and the noise is omitted since

## the motor can’t physically accelerate or

significantly alter the RPM output.

Figure 24 however shows the correct RPM being reported by the tachometer after filtering

the noise digitally through signal rate of change analysis.

After the tachometer was successfully calibrated, the Dynamometer temperature sensor was

installed and calibrated by submerging the thermocouple end in boiling water followed by

Fig 23: Measurement noise being reported in RPM by controller

Fig 24: Calibrated Motor Tachometer subjecting it to the surface of an ice-cube. If the water measures 100°C when boiling and

approximately 0°C on the surface of the ice-cube, the sensor is reporting accurately enough

for the Dynamometer to compare generator temperature rise vs power output. Once the

## thermocouple was calibrated, baseline measurements of the machine’s motor temperature and

MOSFET heatsink temperature after running at maximum RPM for 10 minutes were

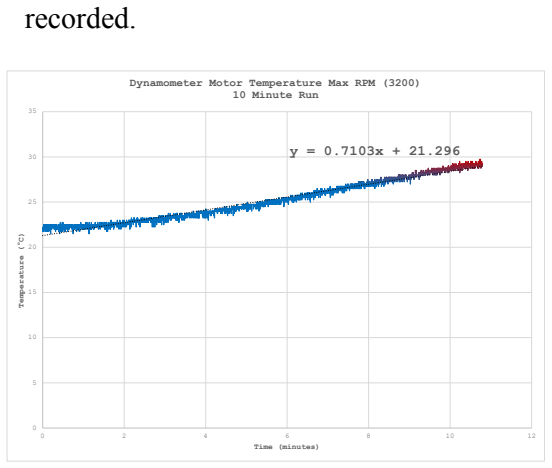
[picture p45: figure]
recorded.; Temperature ( C); Time (minutes); 10 Minute Run
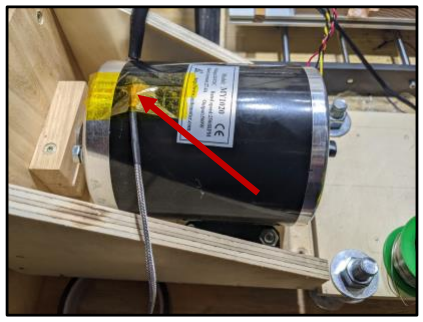
[picture p46: figure]

The machine motor temperature increased at

approximately 0.75°C per minute for 10 minutes

while operating at maximum RPM with no load

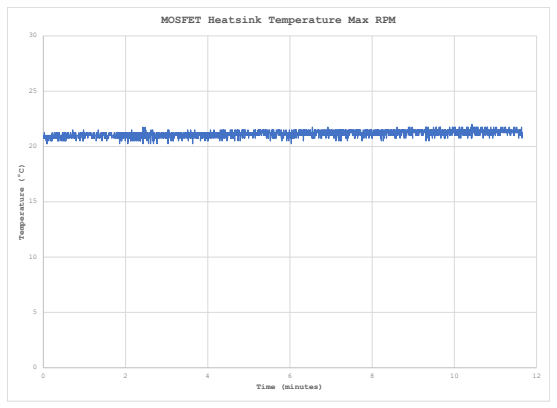
[picture p47: figure]
Temperature ( C); Time (minutes); MOSFET Heatsink Temperature Max RPM

attached. The temperature of the MOSFET heatsink,

as measured next to the M3 mounting screw of the

MOSFET, maintained a relatively stable temperature

of 21°C while operating at maximum RPM with

no load attached.

Calibration of the Dynamometer load cell began by

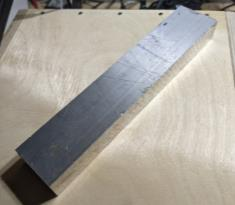
[picture p48: figure]

measuring the mass of an aluminum block with a kitchen scale to be 396.58(g).

Dynamometer Motor Temperature Max RPM (3200)

Fig 25: Motor Temperature Rise after 10 minutes | Fig 26: MOSFET Heatsink Temperature Rise after 10 minutes

Fig 27: Thermocouple sampling location on motor from heat rise graph

Fig 28: Aluminum
Block

The aluminum block was then placed on the load cell while executing the load cell

calibration sketch included with the HX711 library which can be referenced in the appendix.

In the sketch, a load cell calibration factor is tuned through an active console session until the

output of the load cell matches the output of the kitchen scale.

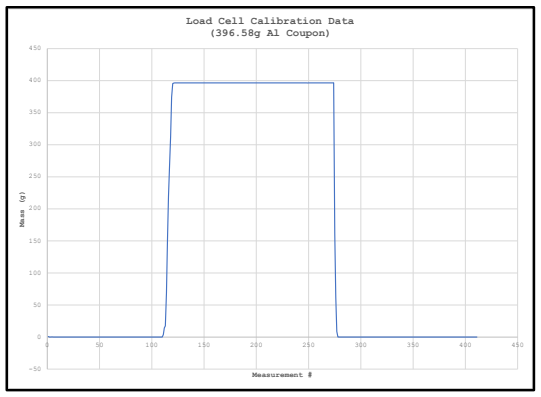
[picture p49: figure]
Mass (g); Measurement #; Load Cell Calibration Data (396.58g Al Coupon)
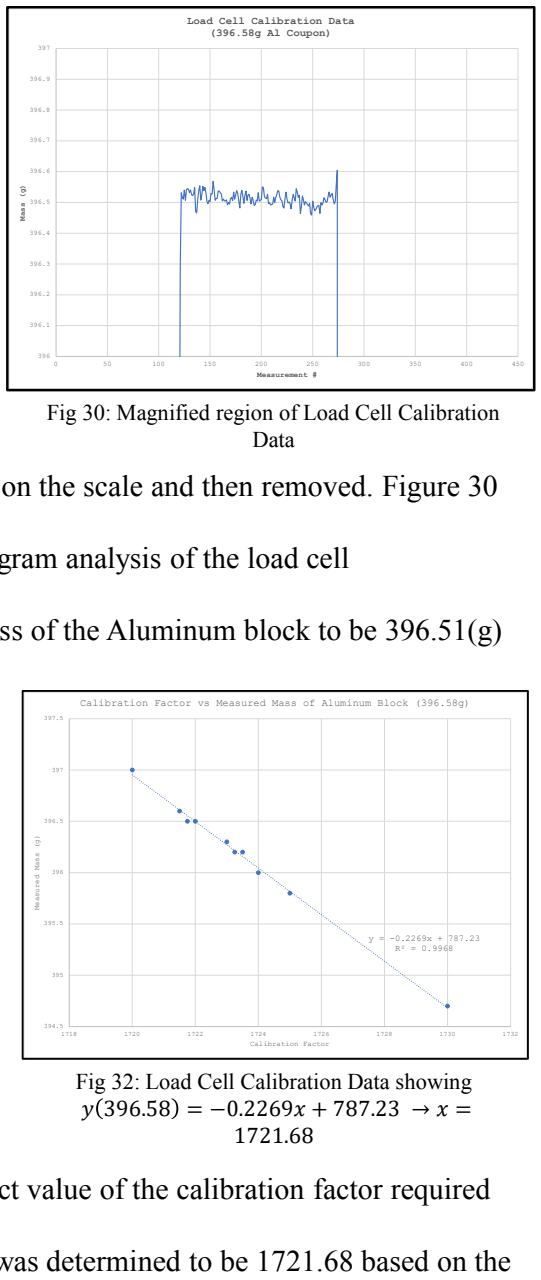
[picture p50: figure]
Mass (g); Measurement #; Load Cell Calibration Data (396.58g Al Coupon); Data; Measured Mass (g); Calibration Factor y 396.58 = −0.2269x + 787.23 → x = 1721.68

Figure 29 shows the aluminum block being placed on the scale and then removed. Figure 30

shows a magnified region around 396.5(g). A histogram analysis of the load cell

measurement data shows the average measured mass of the Aluminum block to be 396.51(g)

Fig:___ shows the method used for finding the exact value of the calibration factor required

for the aluminum block to measure 396.58(g) and was determined to be 1721.68 based on the

data collected.

Fig 29: Load Cell Calibration Data | Fig 30: Magnified region of Load Cell Calibration

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
396.45 | 396.5 | 396.55 | 396.6 | 396.65

# of Measurements

Mass (g)

Histogram Data Analysis:
Mass of Aluminum block Calibration Data

Fig 31: Frequency of data reported by load cell

Calibration Factor vs Measured Mass of Aluminum Block (396.58g)

Fig 32: Load Cell Calibration Data showing

With the sensor suite fully functional, a spring can be added to the Dynamometer lever arm

to keep it in constant contact with the load cell. Since the load cell now has the added force

pressing down on it from the spring, the code executes a tare( ) function before recording any

measurements in order to zero the scale. The spring location was chosen to have minimal
force pulling down on the load cell so that it’s rated values were not exceeded. The current

spring location and spring size correlates to 300(g) pulling down on the load cell. This value

may have to be decreased if the load cell becomes saturated, or the load cell size could be

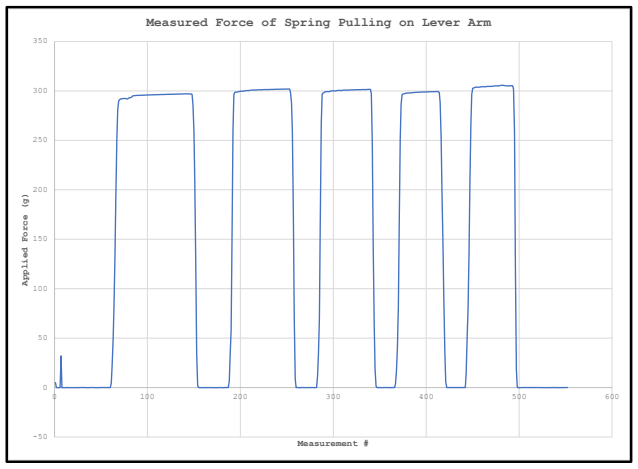
[picture p51: figure]
Applied Force (g); Measurement #

increased to the 5kg max version.

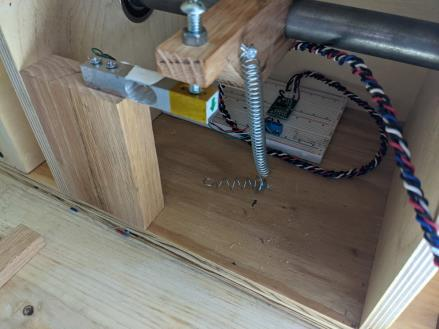
[picture p52: figure]

After inspecting the

location of the spring and

determining its location to

be sufficient for testing

purposes, the Dynamometer

can now deploy all three of

its sensors nearly

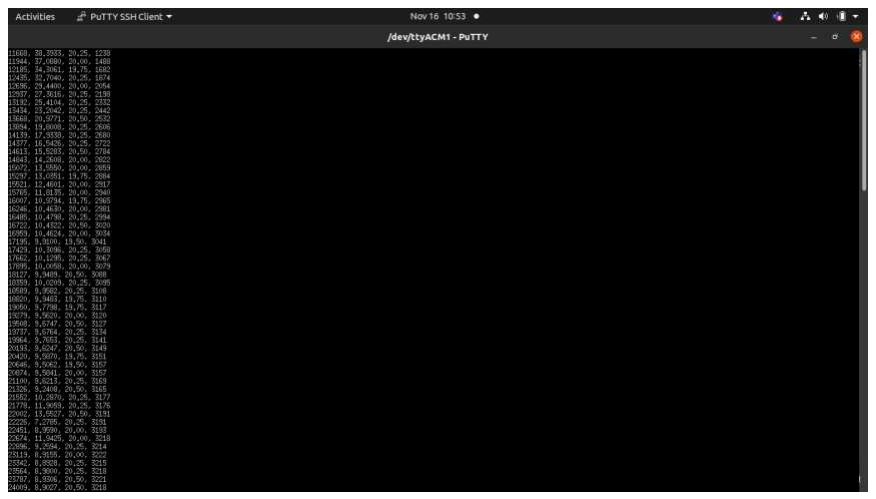
[picture p53: figure]

simultaneously to produce an output as shown in Figure 35 with comma delimited data

points.

Fig 33: Load Cell Spring Location

Measured Force of Spring Pulling on Lever Arm

Fig 34: Five measurements of the spring force pulling down on the load cell

Fig 35: Time (ms), Force (g), Temperature (°C), ω (RPM)

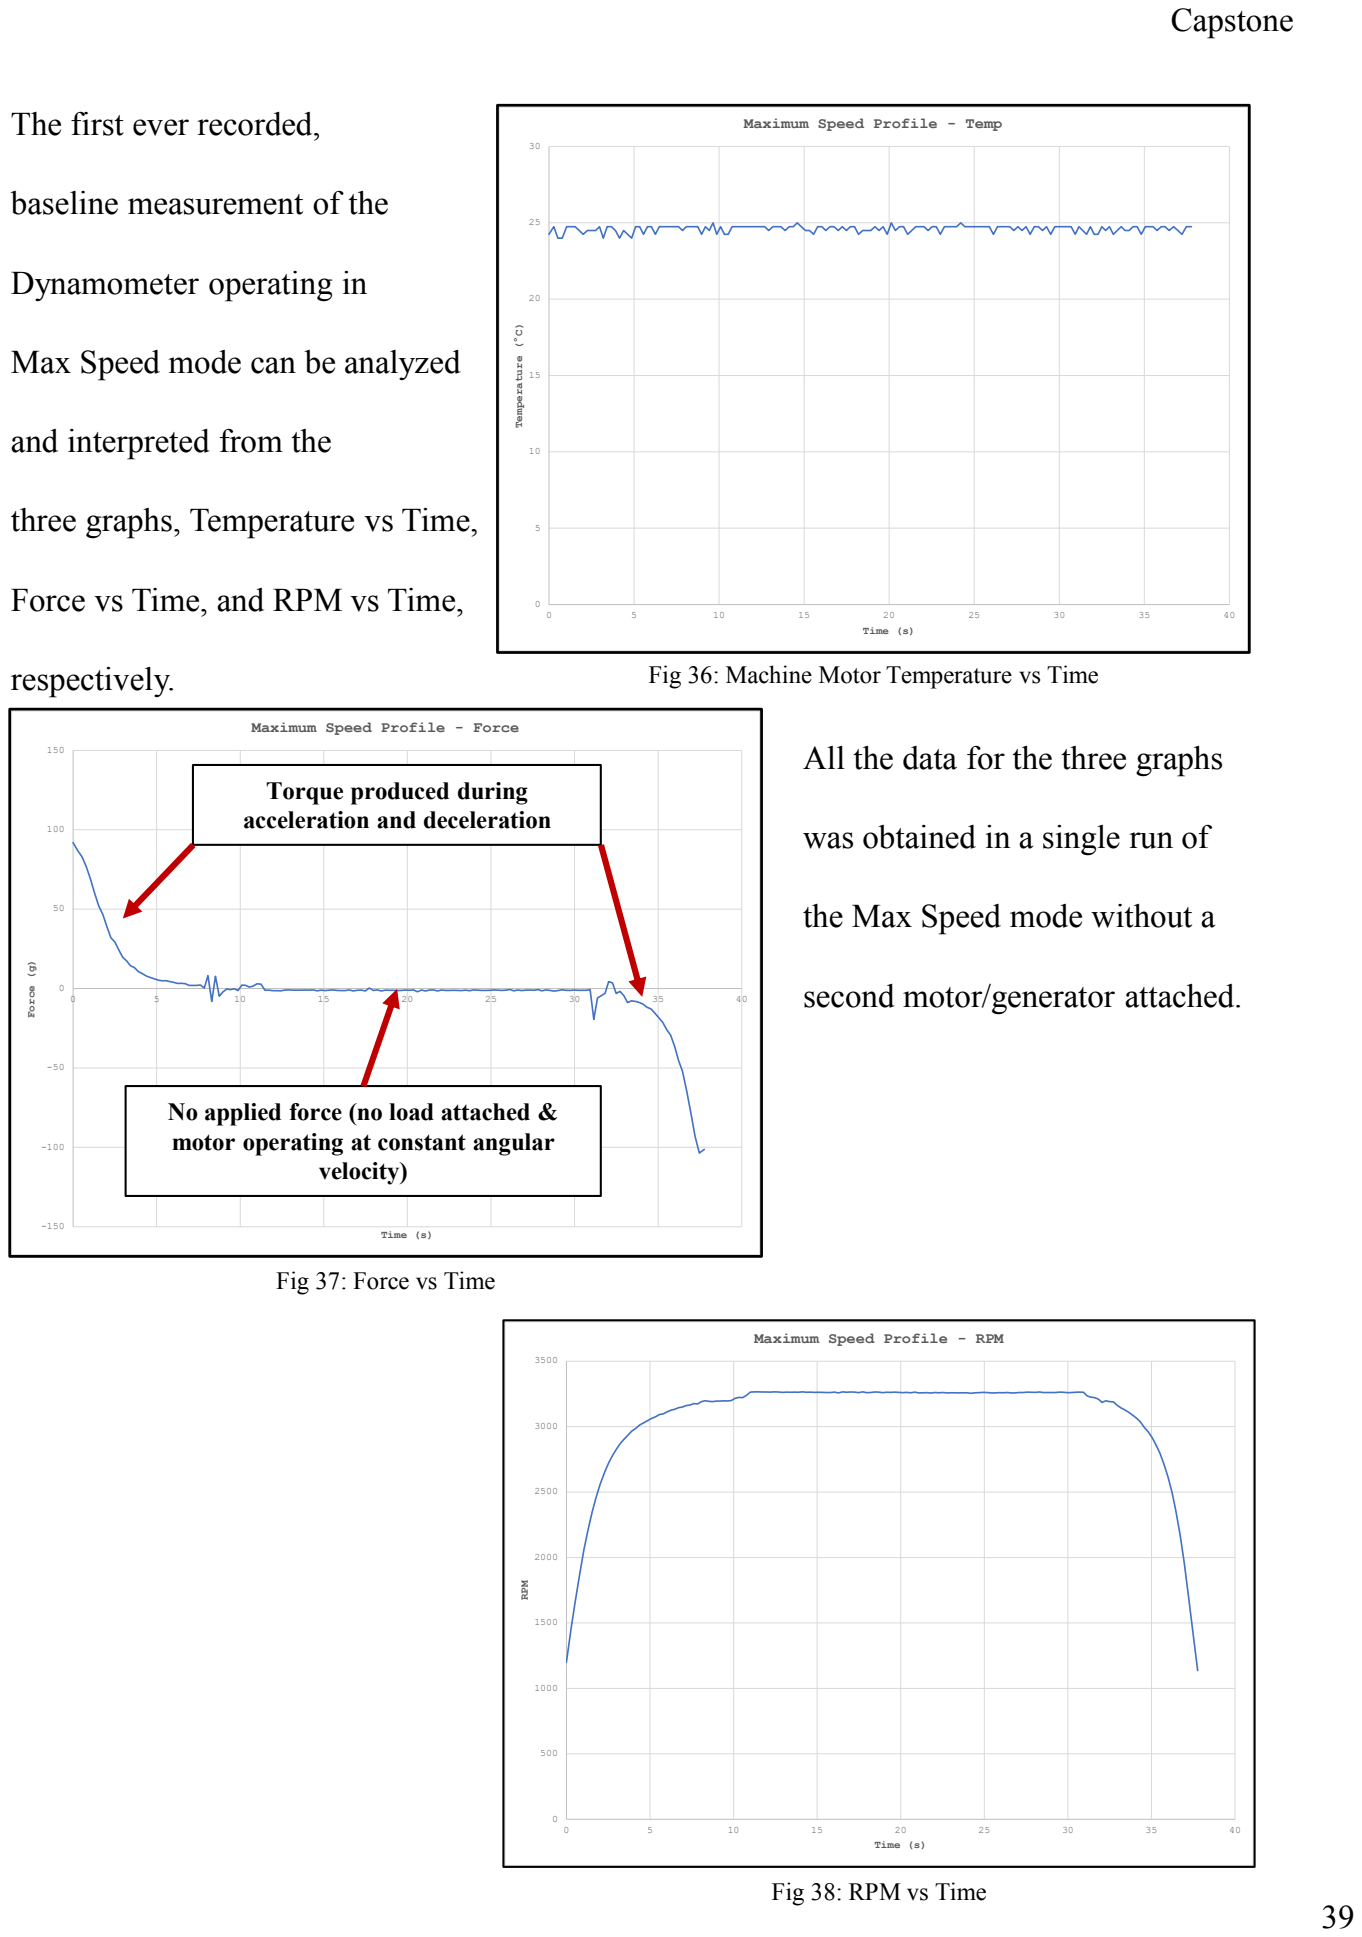
[picture p54: page 39]
respectively.; Temperature ( C); Time (s); Force (g); RPM

The first ever recorded,

Maximum Speed Profile - Temp

baseline measurement of the

Dynamometer operating in

Max Speed mode can be analyzed

and interpreted from the

three graphs, Temperature vs Time,

Force vs Time, and RPM vs Time,

Fig 36: Machine Motor Temperature vs Time

Maximum Speed Profile - Force

All the data for the three graphs

Torque produced during
acceleration and deceleration

was obtained in a single run of

the Max Speed mode without a

second motor/generator attached.

No applied force (no load attached & motor | operating at constant angular

velocity)

Fig 37: Force vs Time

Maximum Speed Profile - RPM

Fig 38: RPM vs Time

# Generator Performance

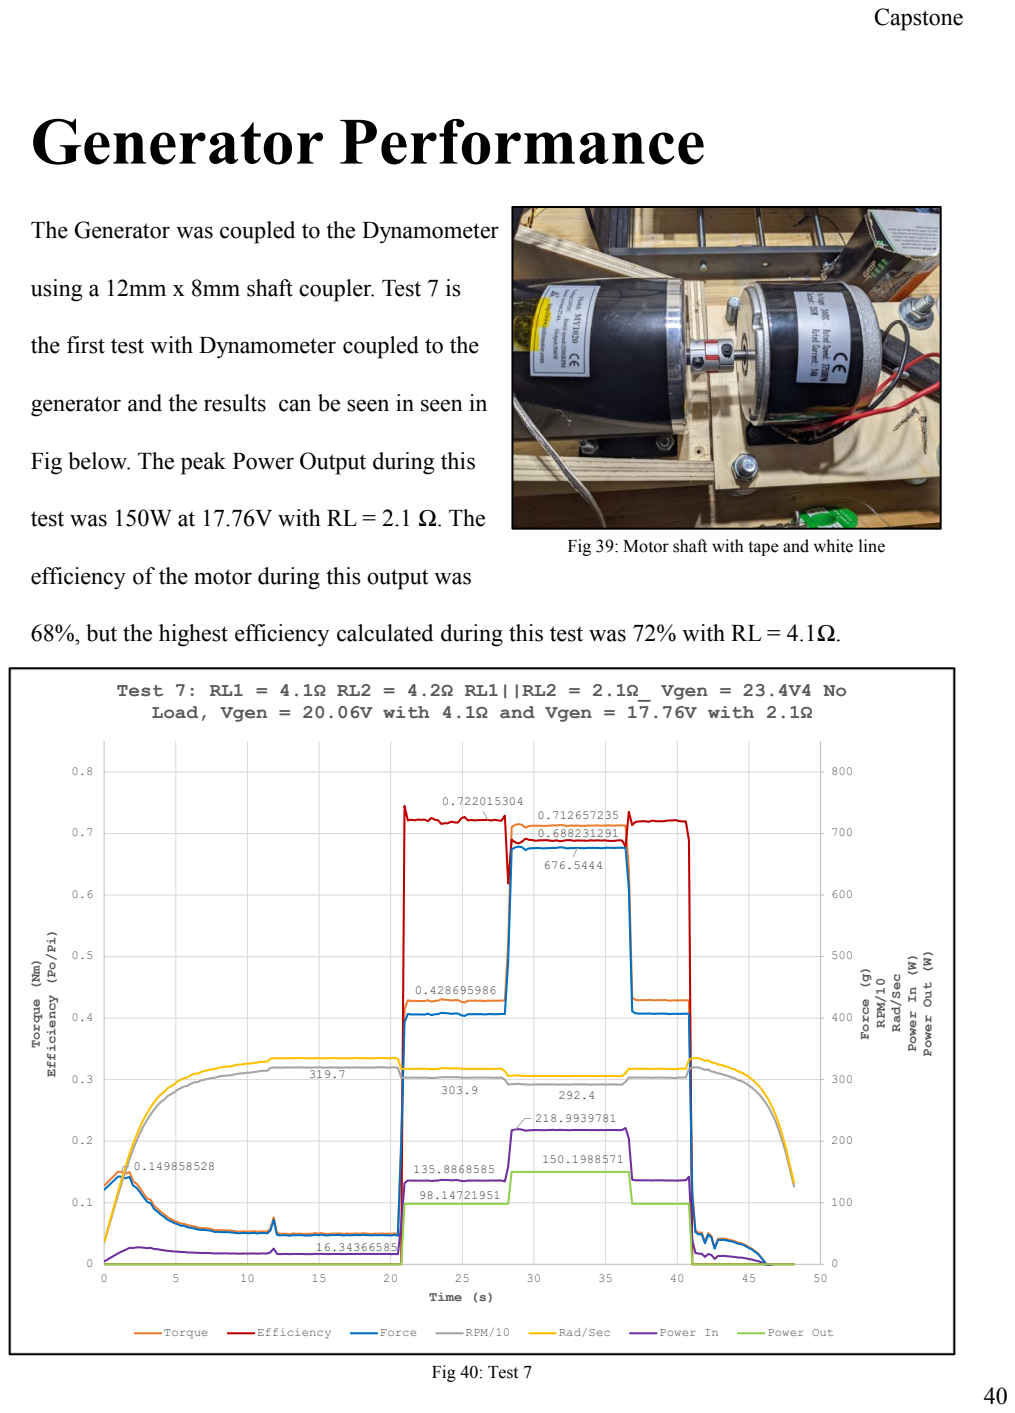
[picture p55: page 40]
Force (g); RPM/10; Rad/Sec; Power In (W); Power Out (W); Torque (Nm); Time (s); Torque; Efficiency; Force; Power In; Power Out; Fig 40: Test 7

The Generator was coupled to the Dynamometer

using a 12mm x 8mm shaft coupler. Test 7 is

the first test with Dynamometer coupled to the

generator and the results can be seen in seen in

Fig below. The peak Power Output during this

test was 150W at 17.76V with RL = 2.1 Ω. The

Fig 39: Motor shaft with tape and white line

efficiency of the motor during this output was

68%, but the highest efficiency calculated during this test was 72% with RL = 4.1Ω.

Test 7: RL1 = 4.1Ω RL2 = 4.2Ω RL1||RL2 = 2.1Ω_ Vgen = 23.4V4 No
Load, Vgen = 20.06V with 4.1Ω and Vgen = 17.76V with 2.1Ω

Efficiency (Po/Pi)

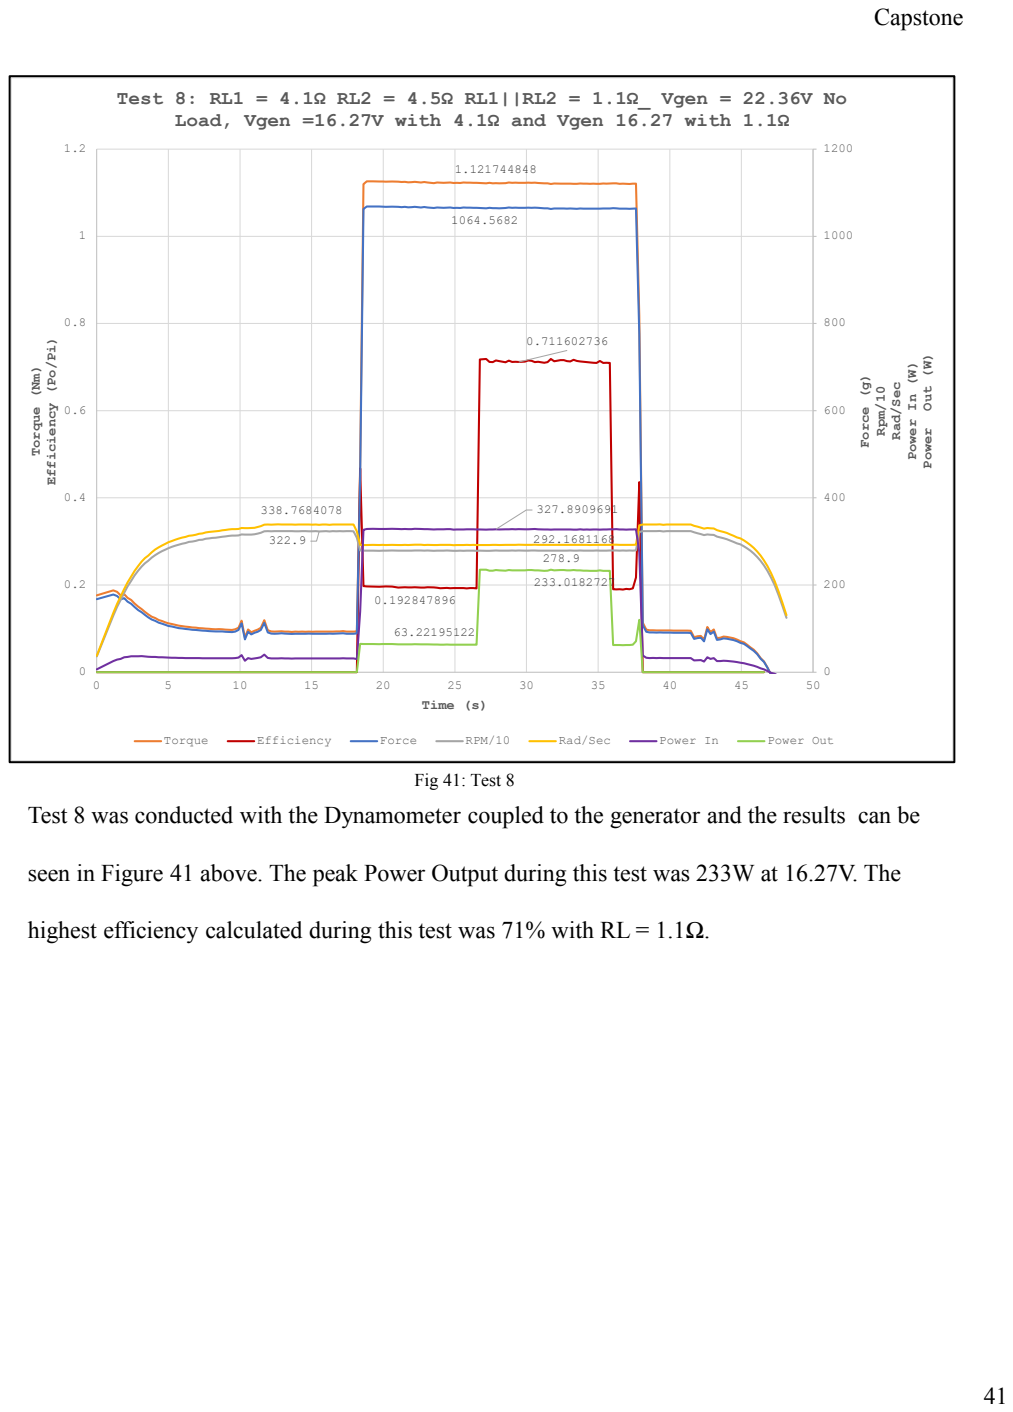
[picture p56: page 41]
Fig 41: Test 8; Force (g); Rpm/10; Rad/Sec; Power In (W); Power Out (W); Torque (Nm); Time (s); Torque; Efficiency; Force; RPM/10; Power In; Power Out

Test 8: RL1 = 4.1Ω RL2 = 4.5Ω RL1||RL2 = 1.1Ω_ Vgen = 22.36V No
Load, Vgen =16.27V with 4.1Ω and Vgen 16.27 with 1.1Ω

Efficiency (Po/Pi)

Test 8 was conducted with the Dynamometer coupled to the generator and the results can be

seen in Figure 41 above. The peak Power Output during this test was 233W at 16.27V. The

highest efficiency calculated during this test was 71% with RL = 1.1Ω.

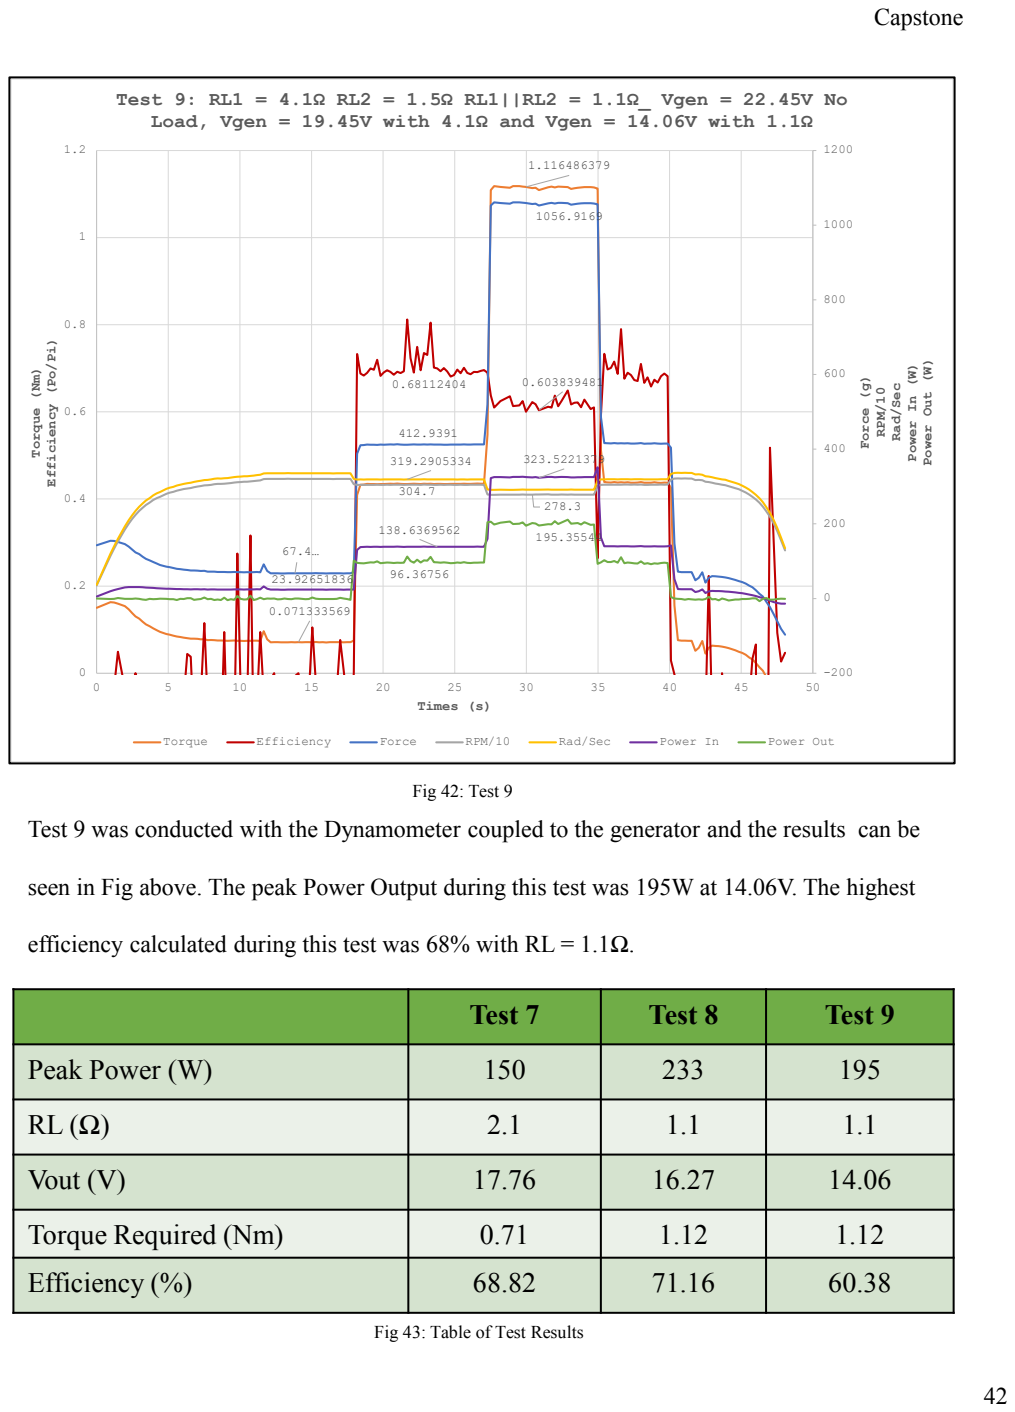
[picture p57: page 42]
Fig 42: Test 9; Force (g); RPM/10; Rad/Sec; Power In (W); Power Out (W); Torque (Nm); Times (s); Torque; Efficiency; Force; Power In; Power Out

Test 9: RL1 = 4.1Ω RL2 = 1.5Ω RL1||RL2 = 1.1Ω_ Vgen = 22.45V No
Load, Vgen = 19.45V with 4.1Ω and Vgen = 14.06V with 1.1Ω

Efficiency (Po/Pi)

Test 9 was conducted with the Dynamometer coupled to the generator and the results can be

seen in Fig above. The peak Power Output during this test was 195W at 14.06V. The highest

efficiency calculated during this test was 68% with RL = 1.1Ω.

Test 7 | Test 8 | Test 9

Peak Power (W) | 150 | 233 | 195
RL (Ω) | 2.1 | 1.1 | 1.1

Vout (V) | 17.76 | 16.27 | 14.06

Torque Required (Nm) | 0.71 | 1.12 | 1.12
Efficiency (%) | 68.82 | 71.16 | 60.38

Fig 43: Table of Test Results

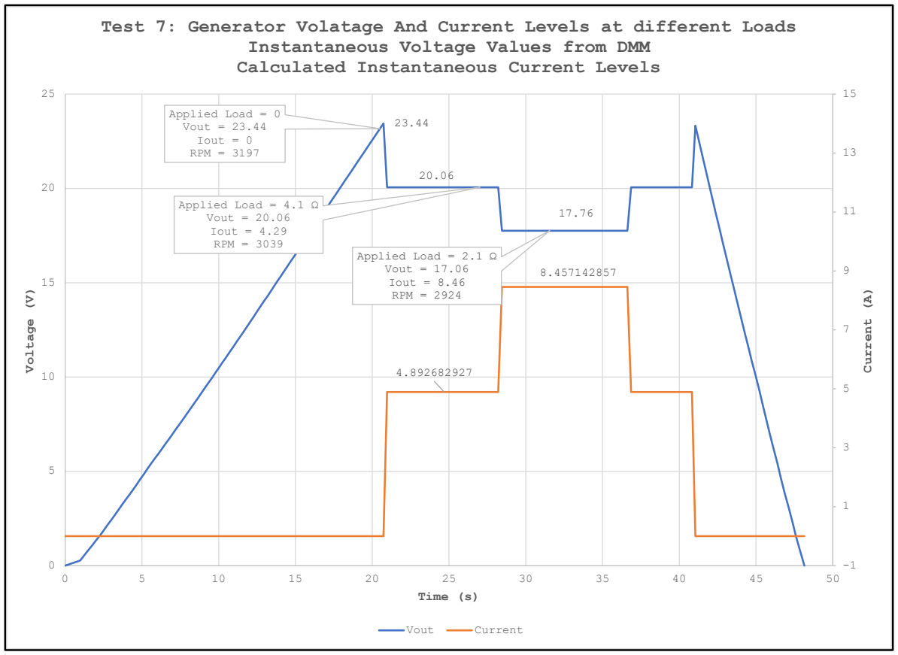
[picture p58: figure]
RPM = 2924 4.892682927; Voltage (V); Current (A); Time (s); Instantaneous Voltage Values from DMM Calculated Instantaneous Current Levels; Vout; Current

The figure above shows the voltage and current outputs of the motor in response to different

loads. The voltage of the generator was determined by using a DMM and recording the

average DC output during the different load intervals. An output current can be calculated as
V
R

= I where R was measured before the test beginning.

Fig 44: Test 7

Applied Vout Iout = 0 RPM | Load = 0 = 23.44 = 3197 | | 23.44 20.06
Applied Load = 4.1 Ω Vout = 20.06 Iout = 4.29 RPM = 3039 | | Applied Load | Vout = 17.06 Iout = 8.46 | = 2.1 Ω | 17.76 8.457142857

Test 7: Generator Volatage And Current Levels at different Loads

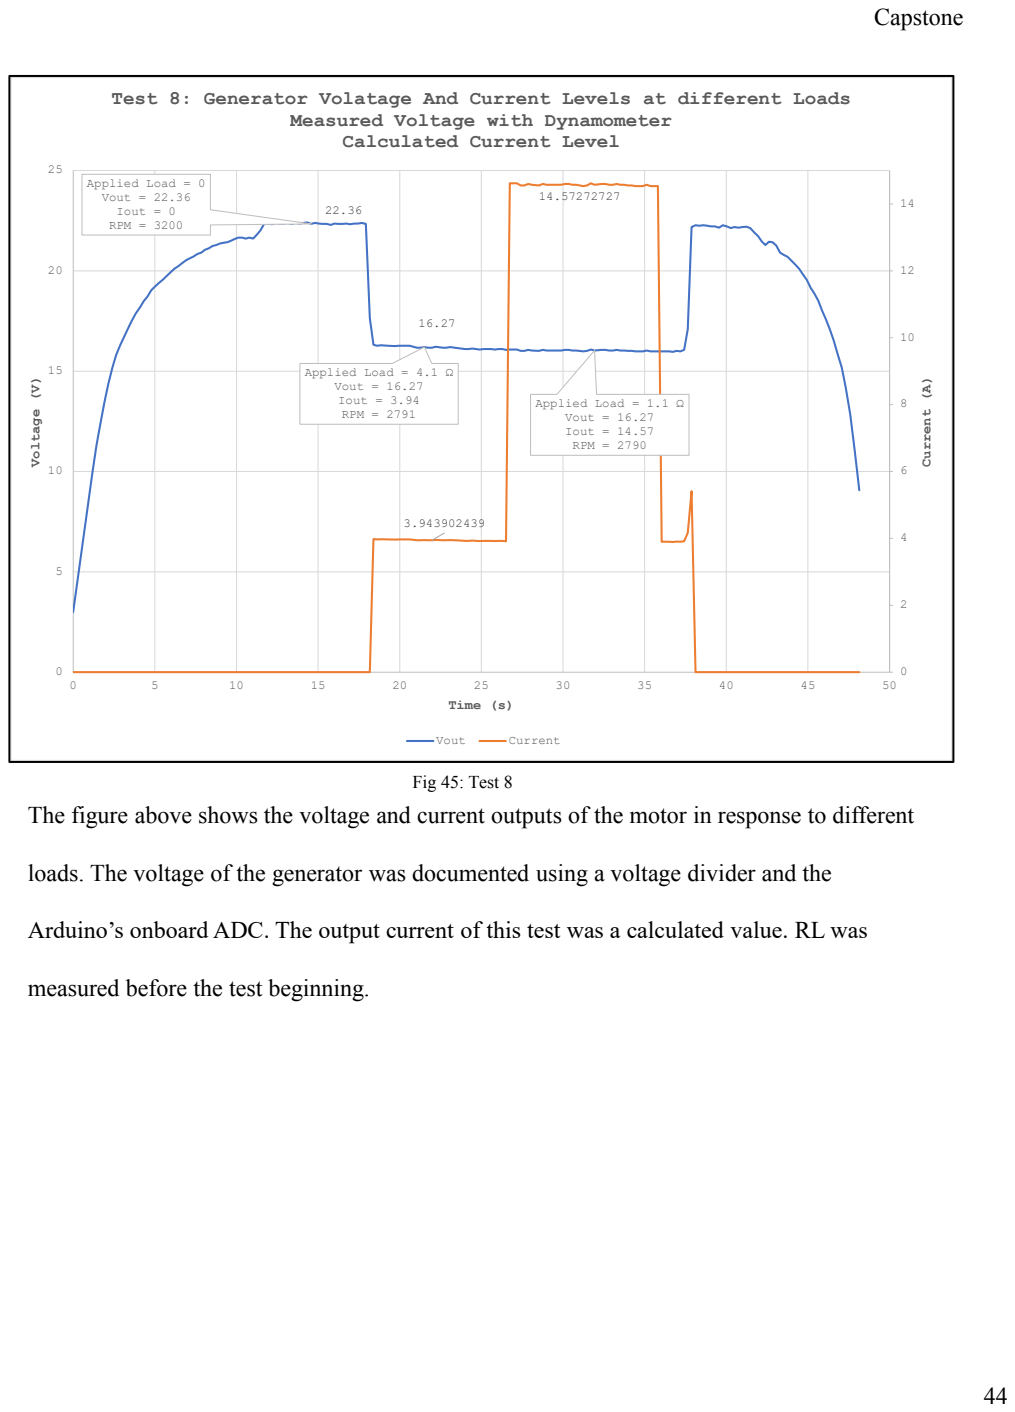
[picture p59: page 44]
Voltage (V); Current (A); Time (s); Vout; Current; Fig 45: Test 8

Test 8: Generator Volatage And Current Levels at different Loads

Measured Voltage with Dynamometer
Calculated Current Level

Applied Load = 0 Vout = Iout RPM = | 22.36 = 0 3200 | | 22.36 | | 14.57272727

Applied Load | | 16.27 = 4.1 Ω

Vout = 16.27 Iout = 3.94 RPM = 2791 | | Applied Load = | Vout = 16.27 Iout = 14.57 RPM = 2790 | 1.1 Ω

The figure above shows the voltage and current outputs of the motor in response to different

loads. The voltage of the generator was documented using a voltage divider and the
Arduino’s onboard ADC. The output current of this test was a calculated value. RL was

measured before the test beginning.

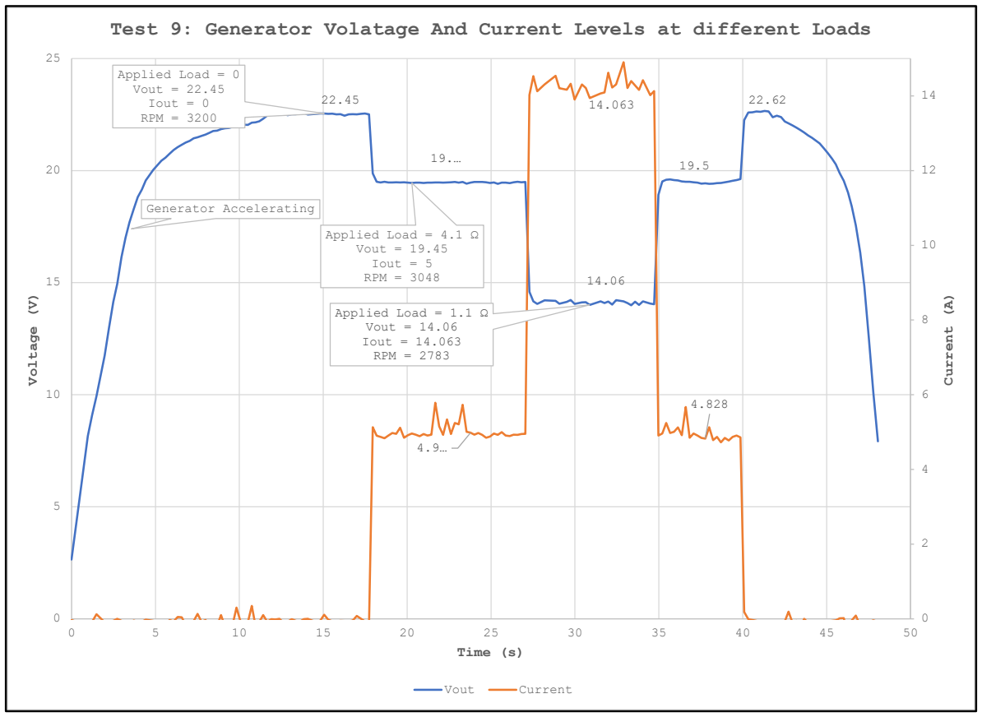
[picture p60: figure]
Voltage (V); Current (A); Time (s); Vout; Current

Applied Load = 0 Vout = 22.45 Iout = 0 RPM = 3200 | 22.45 | 19.… | 14.063 | 19.5 | 22.62
Generator Accelerating | Applied Load = 4.1 Ω Vout = Iout RPM = | 19.45 = 5 3048 | 14.06
| Applied Load = 1.1 Ω Vout = 14.06 Iout = RPM = 2783 | 14.063

Test 9: Generator Volatage And Current Levels at different Loads

The figure above shows the voltage and current outputs of the motor in response to different
loads. The voltage of the generator was measured using a voltage divider and the Arduino’s

onboard ADC. The output current of this test was measured utilizing a hall sensor. RL was

measured before the test beginning.

Fig 46: Test 9

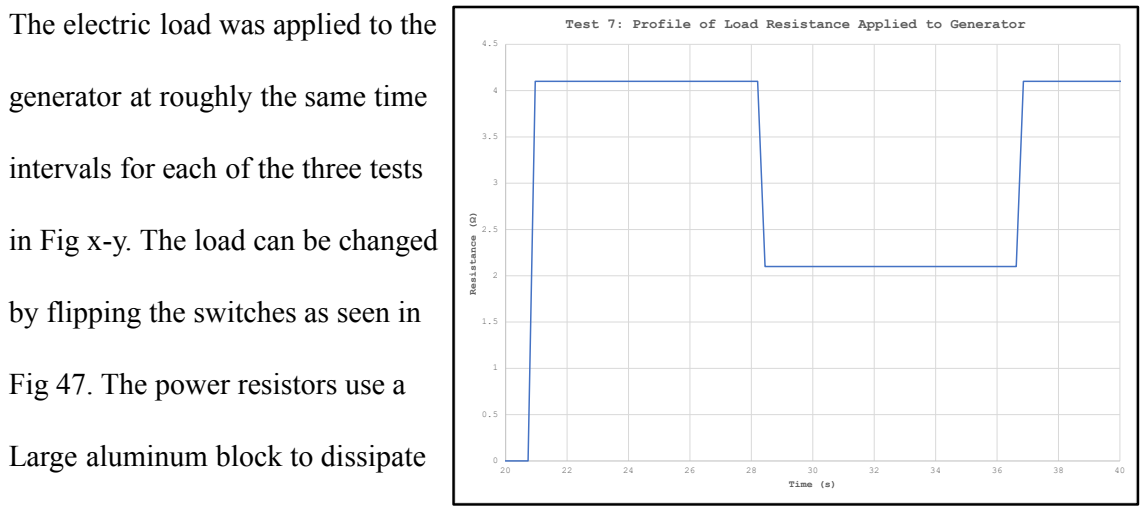
[picture p61: figure]
Resistance (Ω); Time (s); generator at roughly the same time; intervals for each of the three tests; in Fig x-y. The load can be changed; by flipping the switches as seen in; Fig 47. The power resistors use a; Large aluminum block to dissipate
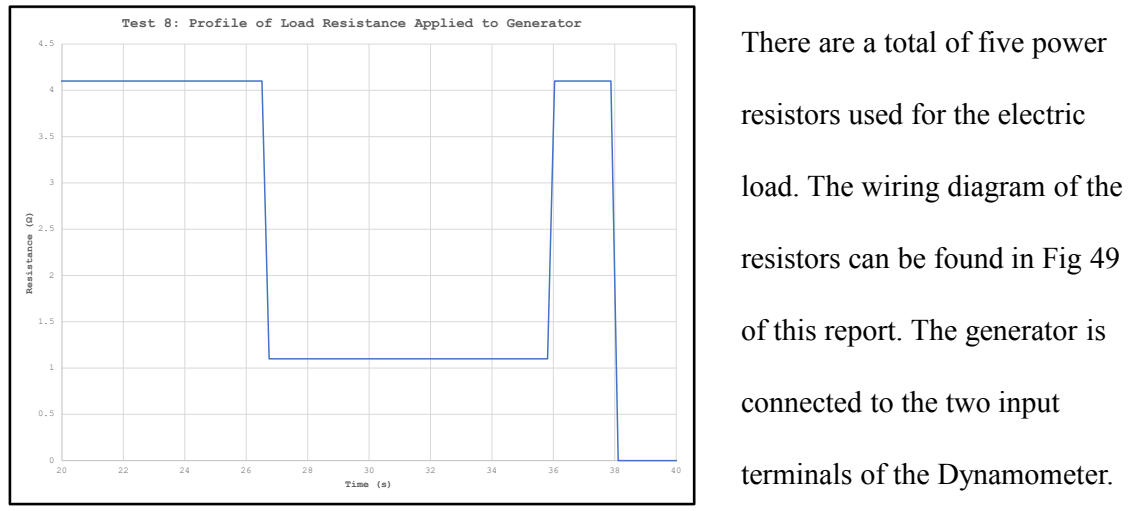
[picture p62: figure]
Resistance (Ω); Time (s); There are a total of five power; resistors used for the electric; load. The wiring diagram of the; resistors can be found in Fig 49; of this report. The generator is; connected to the two input; terminals of the Dynamometer.
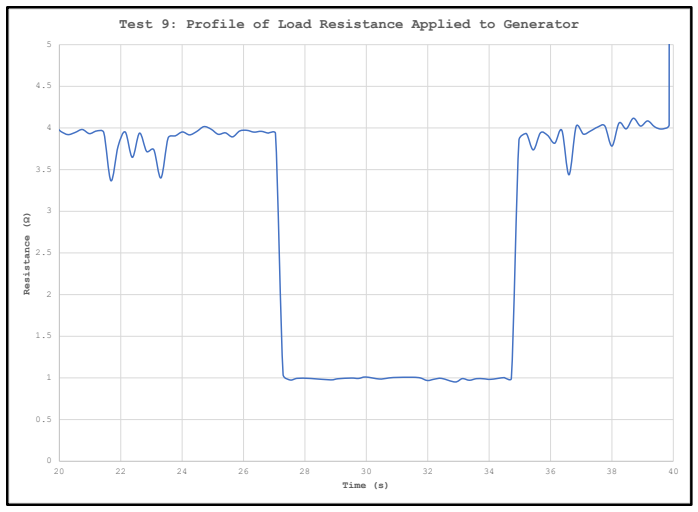
[picture p63: figure]
Resistance (Ω); Time (s)

Test 9: Profile of Load Resistance Applied to Generator

Test 8: Profile of Load Resistance Applied to Generator

The electric load was applied to the | Test 7: Profile of Load Resistance Applied to Generator

the power which peaks near 250W.

Fig 47: Test 7 Applied Load Resistance Profile

Fig 48: Test 8 Applied Load Resistance Profile

Fig 50: Test 9 Applied Load Resistance Profile

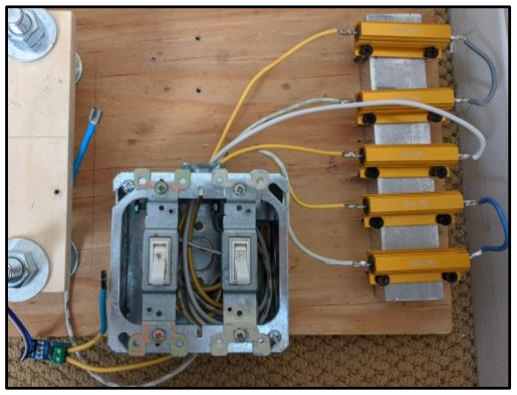
[picture p64: figure]

Fig 49: Electric Load and switches

# Conclusion

The generator purchased by the customer is capable of outputting 195W at 14.06V while

rotating at 2783RPM. This should be more than enough power to charge a 12V DC system.

## The Dynamometer built for testing the customer’s generators, functioned as intended. The

machine is capable of evaluating torque required to spin a generator under loaded or

unloaded conditions. The machine can be re-configured to measure the amount of torque

produced by a motor/generator by swapping power/load leads on the machine. In the default

configuration, the machine is able to compare power input at the shaft to the power output at generator terminals. The efficiency of the generator can the be found as Pout

Pin = efficiency.

The machine measures the following parameters while operating;

1) Torque
2) Temperature
3) RPM
4) Vout
5) Iout

In conclusion, the Dynamometer machine is capable of evaluating motors/generators through

5 different metrics and is considered a success. Future designs of the machine could include

the use of an extruded aluminum frame for more rigidity. The electric load could also be

automatically applied in future iterations to make for consistent time graphs.

# References

## How to Calculate Torque for a Motor – YouTube

## How to Analyse the Performance of a Motor: Setting Up the Matrix Electrical Machines Test Equipment – YouTube

## How to measure torque of a motor? | Torque Testing Stand (futek.com)

## Digital Force Gauge & Weight Scale w/ Loadcell & Arduino -Arduino Project Hub

## Load Cell 1kg | ElectroPeak

## Electric Motors and Drives, Fifth Edition Austin Hughes, Bill Drury Ch2 Power Electronic Converters for motor drives Pg

45-
