ryanshappa/Dynamometer-Project/imgs/Dyno_Concept.png

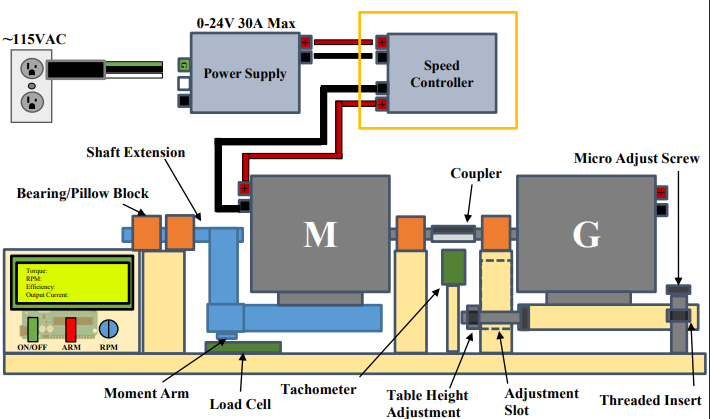
imgs/Dyno_Concept.png
